cheapjack/MileCastles/README.md

## Milecastles

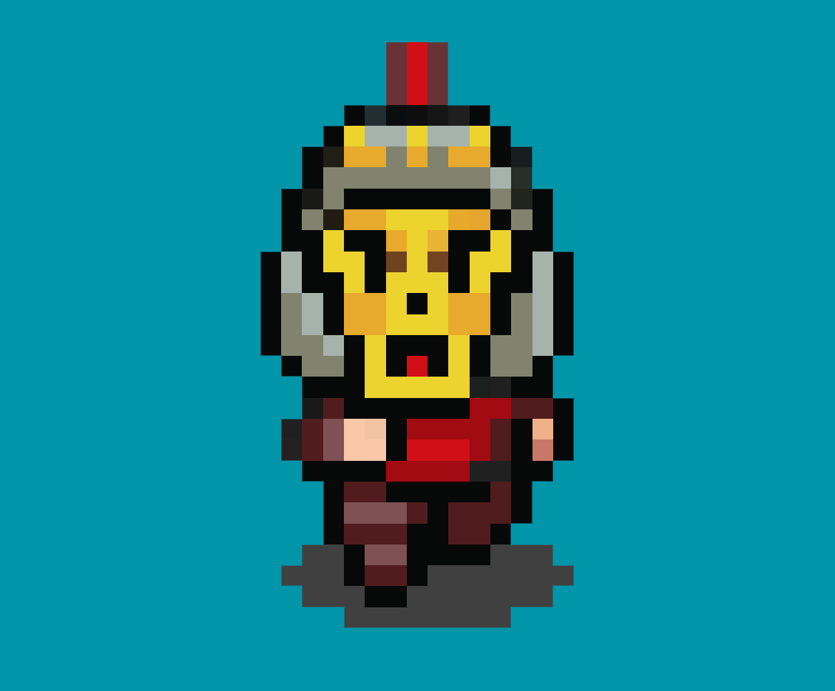
[picture p1: Milecastles-blue-animation.gif]
Soldier Gif


Resources and Issues for development of Milecastles
