cheapjack/MileCastles/boxes/box-colour-refs.pdf

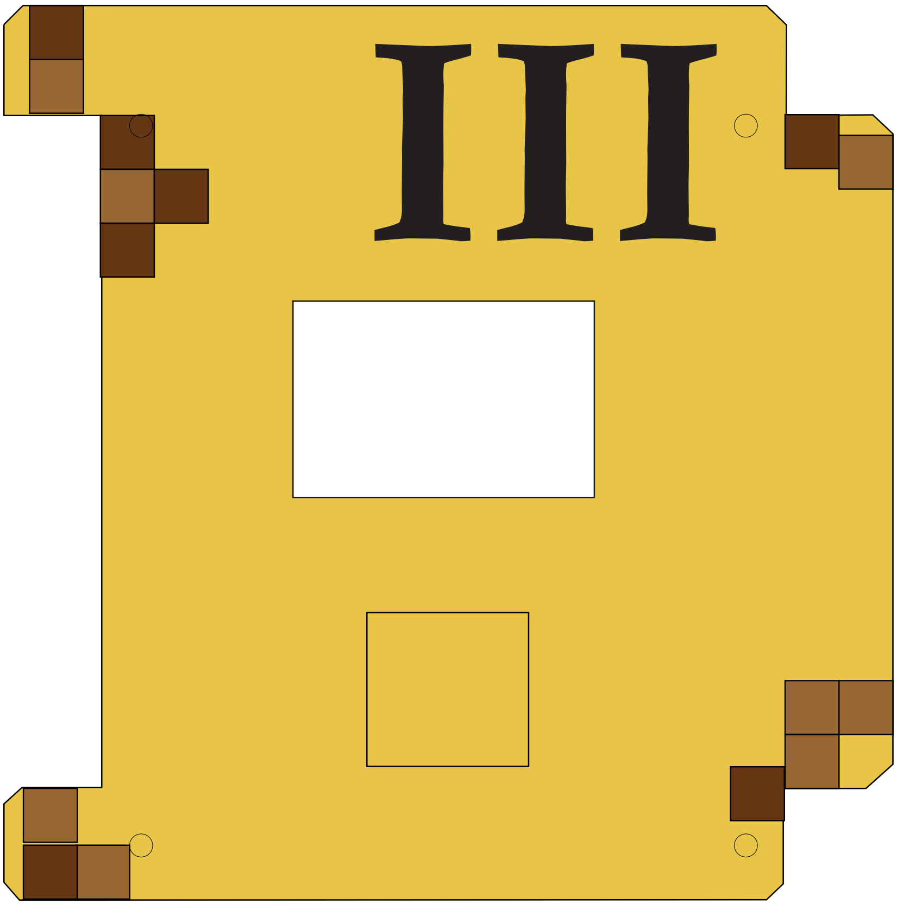
[picture p2: figure]
III
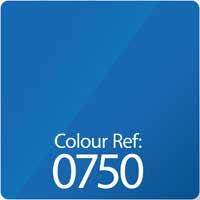
[picture p3: figure]
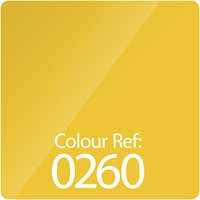
[picture p4: figure]
