cheapjack/MileCastles/screens/1pcs-TM404A-E108467-40x4-4004-40-4-Character-LCD-Module-Yellow-Green-NO-LED-Backlight-KS0066.jpg

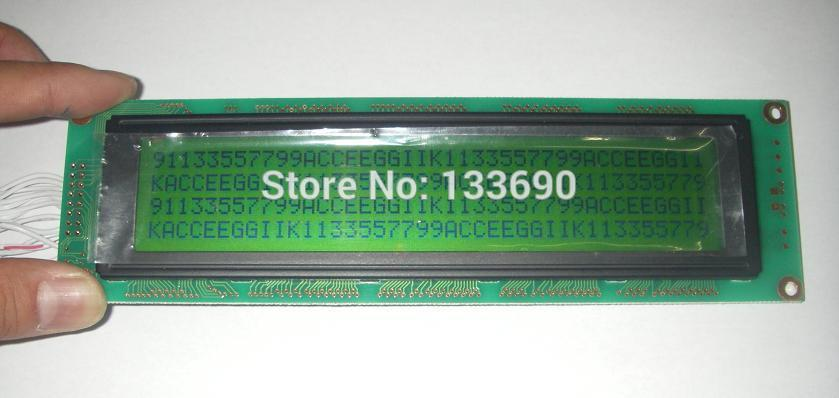
screens/1pcs-TM404A-E108467-40x4-4004-40-4-Character-LCD-Module-Yellow-Green-NO-LED-Backlight-KS0066.jpg
