cheapjack/MileCastles/screens/24-149-thickbox.jpg

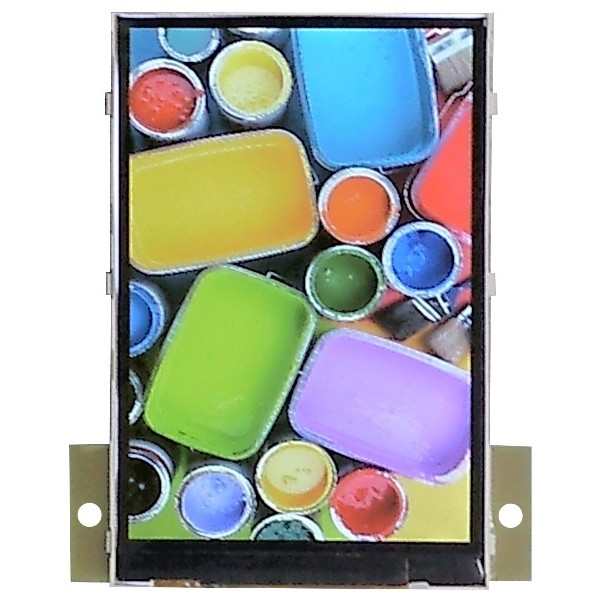
screens/24-149-thickbox.jpg
