cheapjack/MileCastles/screens/24-152-thickbox.jpg

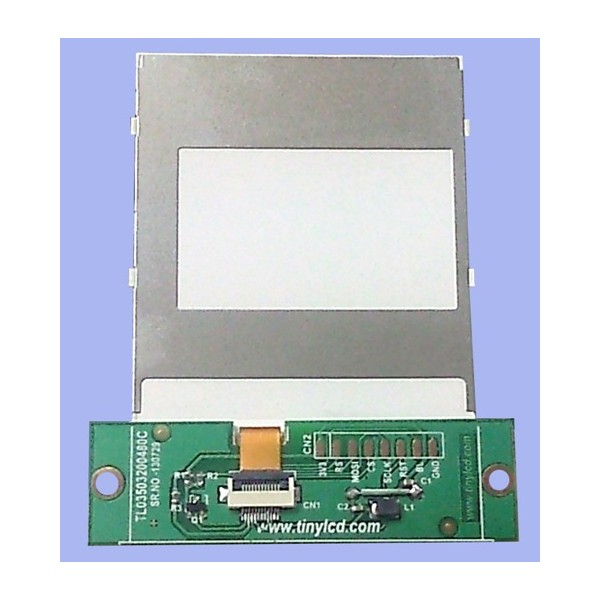
screens/24-152-thickbox.jpg
