cheapjack/MileCastles/screens/61EtGUKPeWL._SL1000_.jpg

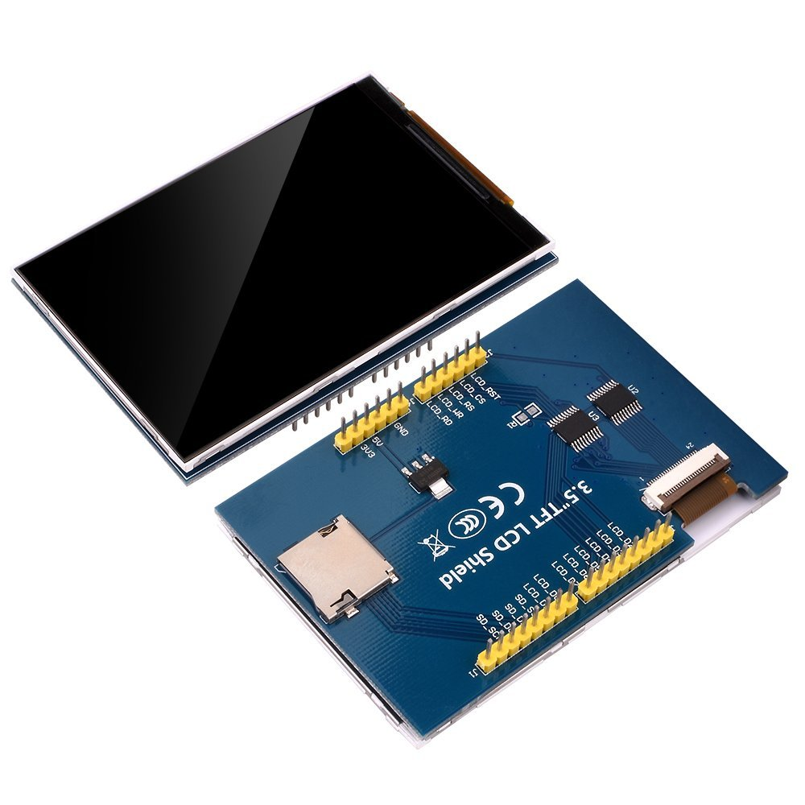
screens/61EtGUKPeWL._SL1000_.jpg
