cheapjack/MileCastles/screens/banggood_arduino_shield.png

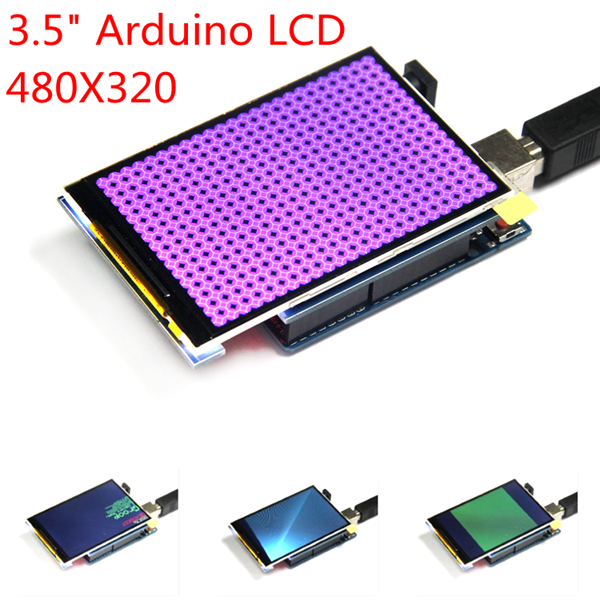
screens/banggood_arduino_shield.png
