cheapjack/MileCastles/screens/buydisplay-spi-3.5in-tft-lcd-320x480-touchscreen.jpg

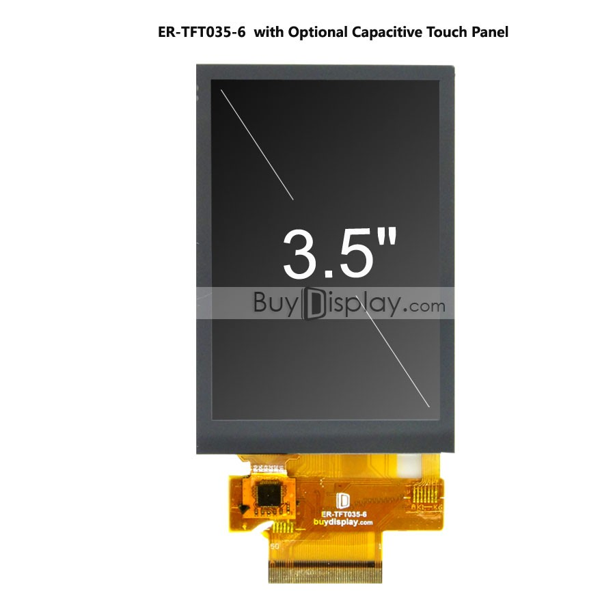
screens/buydisplay-spi-3.5in-tft-lcd-320x480-touchscreen.jpg
