cheapjack/MileCastles/screens/s-l1600.jpg

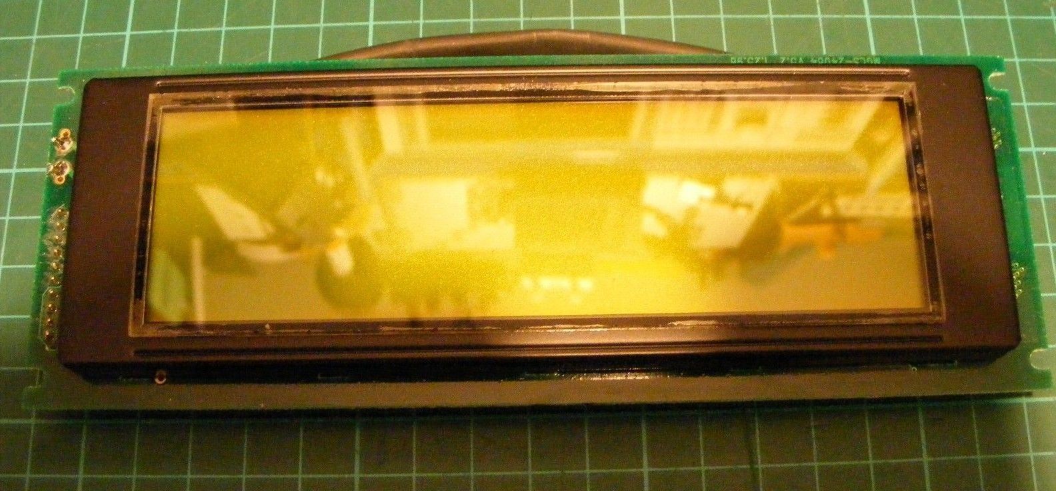
screens/s-l1600.jpg
