cheapjack/MileCastles/screens/TG12864H3-05MB0 - RGB Backlight LCD.jpg

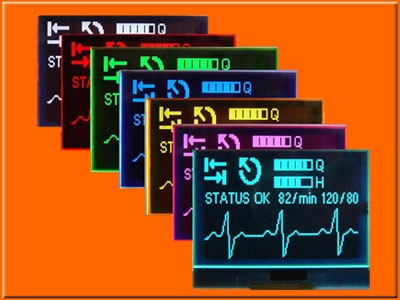
screens/TG12864H3-05MB0 - RGB Backlight LCD.jpg
