cheapjack/MileCastles/componentlist.md

# ComponentList :scroll:

|Item|Got them
|----|----
|RFID tags [with this reader](http://www.electrodragon.com/product/mifare-rc522-rfid-card-readerdetector-ic-card/) **YES**|<ul><li>[x] </li>
|MileCastle round Cavalryman Sticker|<ul><li>[x] </li>

# Boxes Minimum
**17 internals**
**5 externals**
**1 internal with battery**

# Colours for interior
Senhouse 3 white
Tullie 3 white 1 black
Corbridge 3 white
Housesteads 1 white

25 screens in white
25 cockles

## Internals for interior Boxes
|Item|Got them
|----|----
|Headers & dupont connectors|<ul><li>[ ] </li>
|400 point breadboard|<ul><li>[ ] </li>
|Micropython Cockle|<ul><li>[ ] </li>
|90 degree headers for screens|<ul><li>[ ] </li>
|90 degree headers for readers|<ul><li>[ ] </li>
|2 and 4 Dupont Connector Blocks for readers
|1 single male to female for readers
|2 x 4 Dupont Block for Screens|
|2 single male to female for Screens
|2 power jumpers to make a 5V rail for Screens
All 15mm gauge
|[RFID-RC522](http://www.electrodragon.com/product/mifare-rc522-rfid-card-readerdetector-ic-card/) Read/Writers|<ul><li>[x] </li>
|128x64 White Backlit LCD pixel screens|<ul><li>[ ] </li>
|[Panel mount internal micro-USB-B extension](https://www.aliexpress.com/item/1PCS-lot-150CM-OBD-II-OBD2-16-Pin-Male-to-Female-Diagnostic-Extension-Cable/1482186322.html) from micropython cockle port|<ul><li>[x] </li>
|Female USB-A Mains Plug|<ul><li>[x] </li>
|White Male USB-A to Male micro USB-B Extension 3M|<ul><li>[x] </li>
|Female to Male USB-A extenders|<ul><li>[ ] </li>

## Internals for 5 Off-grid Boxes
|Item|Got them
|----|----
|IP66/8 grommet|<ul><li>[x] </li>
|reed switch & magnet|<ul><li>[ ] </li>
|[IP66/68 Rated Waterproof Boxes](https://www.aliexpress.com/item/Low-shipping-cost-high-quality-ip66-plastic-enclosure-box-with-transparent-lid-140-170-95mm/1708264367.html)|<ul><li>[x] </li>
|Headers & dupont connectors|<ul><li>[ ] </li>|<ul><li>[x] </li>
|90 degree headers for screens|<ul><li>[ ] </li>
|90 degree headers for readers|<ul><li>[ ] </li>
|400 point breadboard|<ul><li>[ ] </li>
|Micropython Cockle|<ul><li>[ ] </li>
|[RFID-RC522](http://www.electrodragon.com/product/mifare-rc522-rfid-card-readerdetector-ic-card/) Read/Writers|<ul><li>[x] </li>
|128x64 White Backlit LCD pixel screens|<ul><li>[x] </li>
|Micro B Male to |<ul><li>[x] </li>

## Externals for Off-grid Boxes
|Item|Got them
|----|----
|Internal & External Fixings for side/rear fixing to fence posts/signs|<ul><li>[ ] </li>
|Battery Pack bracket on reverse: additional through hole fixings|<ul><li>[x] </li>
|Box acrylic bent wings for lid socket|<ul><li>[ ] </li>
|Adjust skin for lid|<ul><li>[ ] </li>
|Tinted acrylic Lid with inset magnet|<ul><li>[ ] </li>
|USB Charger port/cable & reed switch lines [grommet plug shell cap cover](https://www.aliexpress.com/item/6-Pieces-Waterproof-Aviation-Connector-Plug-Shell-Cap-Cover-for-GX16/2053433214.html) |<ul><li>[x] </li>
|MicroUSB-B (cockle) extension to exiting USB-A via IP66/8 grommet|<ul><li>[ ] </li>
|Exiting USB-A to an external solar battery pack|<ul><li>[ ] </li>
|[USB Solar battery Pack](http://www.ebay.co.uk/itm/Waterproof-12000mAh-Solar-Battery-Quick-Charger-Power-Bank-Pack-For-Mobile-Phone/262902644680)|<ul><li>[x] </li>

## Externals for on-grid & off-grid boxes
|Item|Got them
|----|----
|Decorative acrylic for Outer Case Designs|<ul><li>[x] </li>
|Internal acrylic material|<ul><li>[x] </li>
|M6 10mm for lid socket|<ul><li>[ ] </li>
|M6 70mm [Coach bolts](http://www.ebay.co.uk/itm/191920495458)|<ul><li>[x] </li>
|M6 100mm [Coach bolts](http://www.ebay.co.uk/itm/191920495458) for off-grid boxes|<ul><li>[x] </li>
|M6 120mm [Coach bolts](http://www.ebay.co.uk/itm/191920495458) for off-grid boxes|<ul><li>[ ] </li>
|M6 nuts|<ul><li>[x] </li>
|M6 nut covers|<ul><li>[x] </li>
|M6 washers|<ul><li>[ ] </li>
