cheapjack/MileCastles/screens/sourcing.md

Links corresponding with screen images 

# Purchased

https://www.adafruit.com/products/250

http://www.buydisplay.com/default/graphic-module-128x64-serial-lcd-display-st7920-black-on-white

http://www.ebay.co.uk/itm/302089090235

https://www.aliexpress.com/item-img/1pcs-40x4-4004-40-4-Character-LCD-Module-Yellow-Green-NO-LED-Backlight-KS0066-controller/32479455308.html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

http://www.banggood.com/3_5-Inch-TFT-Color-Screen-Module-320-X-480-Support-Arduino-UNO-Mega2560-p-1022298.html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

# Not purchased

240x64 lcd pixel display £16.50 but limited avail and problem voltages http://www.ebay.co.uk/itm/Varitronix-MGLS-24064-Graphical-Display-Panel-240-X-64-LED-Backlight-Pinouts-/332077671365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

480x320 TFT with SPI and arduino shield breakouts http://www.tinylcd.com/tiny149/product.php?id_product=61 AND http://www.tinylcd.com/tiny149/product.php?id_product=24 (arrived at via http://www.instructables.com/id/Arduino-and-35-Inch-320x480-TFT-LCD-ILI9488-SPI-In/ )

http://www.vatronix.com/products/75.html (suppliers of Adafruit module)

TFT touchscreen needing ZIF http://www.buydisplay.com/default/serial-spi-3-5-inch-tft-lcd-module-in-320x480-optl-touchscreen-ili9488

FPC (ZIF) connector £4 https://thepihut.com/products/adafruit-50-pin-0-5mm-pitch-fpc-adapter (could be used with LCD screens directly, as per https://www.youtube.com/watch?v=X0mwfAqiqkc and https://github.com/wdim0/esp8266_fast_lcd_driver_hspi )

Another TFT shield £19 https://www.amazon.co.uk/arduino-Kuman-Screen-Socket-Arduino/dp/B01J34JO0K
