cheapjack/MileCastles/boxes/hexnut_tile_cap.stl

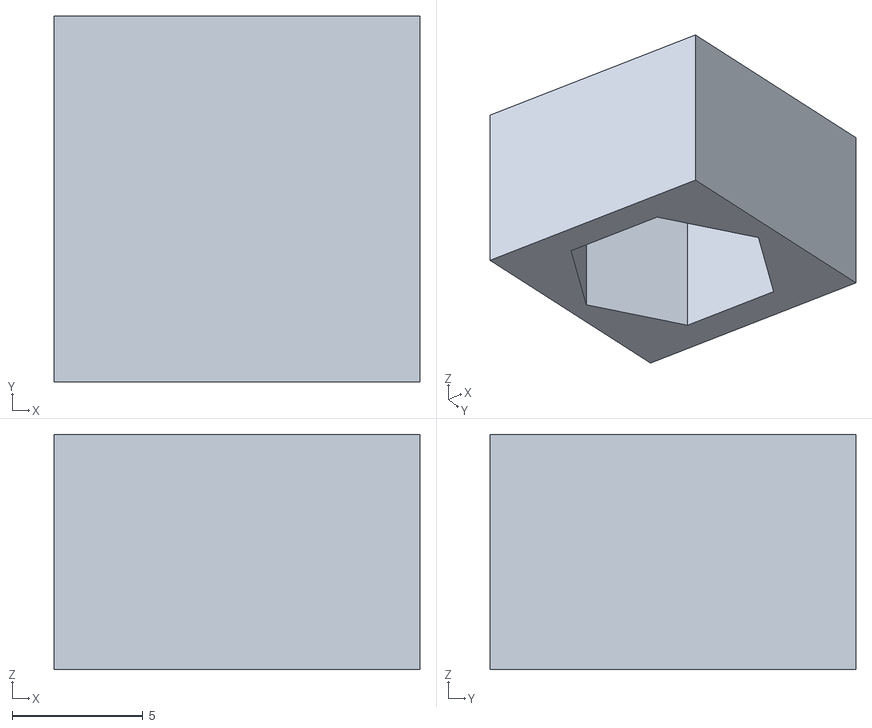
[picture p13: CAD file, 2017-04-25]
boxes/hexnut_tile_cap.stl
14.0 x 14.0 x 9.00
