cheapjack/MileCastles/boxes/AVATOP-INNER-55H-CutsOnSheet.dxf

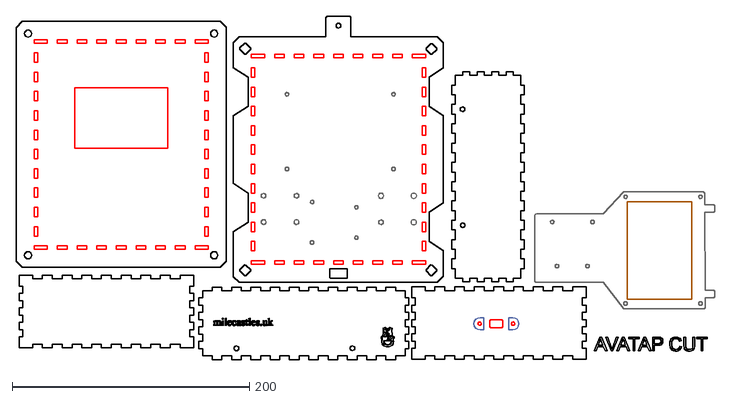
[picture p14: CAD file, 2017-04-17]
boxes/AVATOP-INNER-55H-CutsOnSheet.dxf
589.4 x 289.4
