cheapjack/MileCastles/activity/BoxInstallInfo.md

## Game-Box Install Overview

Live updated [install dates as github issue milestones](https://github.com/cheapjack/MileCastles/milestones)
[Milecastles Site & Logistics Map](https://drive.google.com/open?id=1v-ztNkkMKAI2DC3aoESozsnM2fI&usp=sharing)
[Detailed Info From Site Visits](https://docs.google.com/spreadsheets/d/1O9EbYnrRbLq14Vwc4btC5YH3rWIDOSFfX5Bne3iuhpo/edit?usp=sharing)

## Arbeia (2 indoor, 1 outdoor)
|Venue|Location|Date|Time|Postcode|Phone|Installed|Image No.
|----|----|----|----|----|----|----|----
|Arbeia Roman Fort and Museum|South Shields|tbc|pending|NE33 2BB|0191 277 1410|NO|

|Number of Boxes|Box Type|USB data|Power|Notes
|----|----|----|----|----
|`I,II`|Indoor|OK|OK| 
|`III`|Outdoor|Bad|OK|Will require steel brackets and additional length bolts on top 2 box bolts arranged vertically (supplied). See notes on opening outdoor boxes #114

## Corbridge (3 indoor, 1 outdoor)
|Venue|Location|Date|Time|Postcode|Phone|Installed|Image No.
|----|----|----|----|----|----|----|----
|Corbridge Roman Town|Corbridge|28/6/17|11:30 - 16:30|NE45 5NT|0370 333 1181|YES|YES|1(`corbridge/box*.bin`)

|Number of Boxes|Box Type|USB data|Power|Notes
|----|----|----|----|----
|`I,II,III`|Indoor|OK|OK|
|`IV`|Outdoor|Bad|OK| See notes on opening outdoor boxes #114

## Housesteads (1 indoor, 3 outdoor)
|Venue|Location|Date|Time|Postcode|Phone|Installed|Image No.
|----|----|----|----|----|----|----|----
|Housesteads Roman Fort|Hexham|tbc|tbc|NE47 6NW|01434 344363|NO|NO|

|Number of Boxes|Box Type|USB data|Power|Notes
|----|----|----|----|----
|`I`|Indoor|OK|OK|
|`II`|Outdoor|OK|OK|
|`III,IV`|Outdoor|Bad|OK|See notes on opening outdoor boxes #114

## Segedunum (4 indoor, 1 with battery)
|Venue|Location|Date|Time|Postcode|Phone|Installed|Image No.
|----|----|----|----|----|----|----|----
|Segedunum Roman Fort and Baths|Wallsend|tbc|pending|NE28 6HR|0191 278 4217|NO|NO|

|Number of Boxes|Box Type|USB data|Power|Notes
|----|----|----|----|----
|`I,II,III,IV`|Indoor|OK|OK|`Box IV` needs a battery although its an indoor box. Clear acrylic battery holder with screws supplied 

## Senhouse (3 indoor)
|Venue|Location|Date|Time|Postcode|Phone|Installed|Image No.
|----|----|----|----|----|----|----|----
|Senhouse Roman Museum|Maryport|tbc|tbc|CA15|01900 816168|NO|NO|

|Number of Boxes|Box Type|USB data|Power|Notes
|----|----|----|----|----
|`I,II,III`|Indoor|OK|OK|

## Tullie House (4 indoor)
|Venue|Location|Date|Time|Postcode|Phone|Installed|Image No.
|----|----|----|----|----|----|----|----
|Tullie House Museum and Art Gallery|Carlisle|29/6/17|13:00 - 16:00|CA3 8TP|011228 618718|YES|NO|2(`optimised*.bin`)

|Number of Boxes|Box Type|USB data|Power|Notes
|----|----|----|----|----
|`I,II,III,IV`|Indoor|OK|OK|
