cheapjack/MileCastles/activity/InstallOverview.md

## Game-Box Install Overview

### Installs rolling out inititally Corbridge & Tullie House, then more to follow

Live updated [installs as github issue Milestones](https://github.com/cheapjack/MileCastles/milestones)
[Milecastles Site & Logistics Map](https://drive.google.com/open?id=1v-ztNkkMKAI2DC3aoESozsnM2fI&usp=sharing)
[Info From Site Visits](https://docs.google.com/spreadsheets/d/1O9EbYnrRbLq14Vwc4btC5YH3rWIDOSFfX5Bne3iuhpo/edit?usp=sharing)

|Venue|Location|Date|Time|Postcode|Phone|Installed
|----|----|----|----|----|----|----
|Senhouse Roman Museum|Maryport|tbc|tbc|CA15|01900 816168|NO
Tullie House Museum and Art Gallery|Carlisle|29/6/17|13:00 - 16:00|CA3 8TP|011228 618718|YES
Housesteads Roman Fort|Hexham|tbc|tbc|NE47 6NW|01434 344363|NO
Corbridge Roman Town|Corbridge|28/6/17|11:30 - 16:30|NE45 5NT|0370 333 1181|YES
Segedunum Roman Fort and Baths|Wallsend|tbc|pending|NE28 6HR|0191 278 4217|NO
Arbeia Roman Fort and Museum|South Shields|tbc|pending|NE33 2BB|0191 277 1410|NO
