cheapjack/MileCastles/boxes/WiringRef1.png

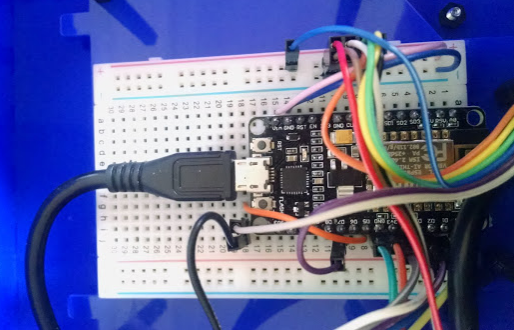
boxes/WiringRef1.png
