cheapjack/MileCastles/boxes/WiringRef2.png

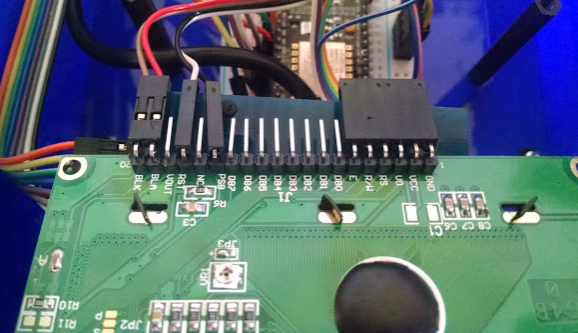
boxes/WiringRef2.png
