cheapjack/MileCastles/print/Milecastles_back.jpg

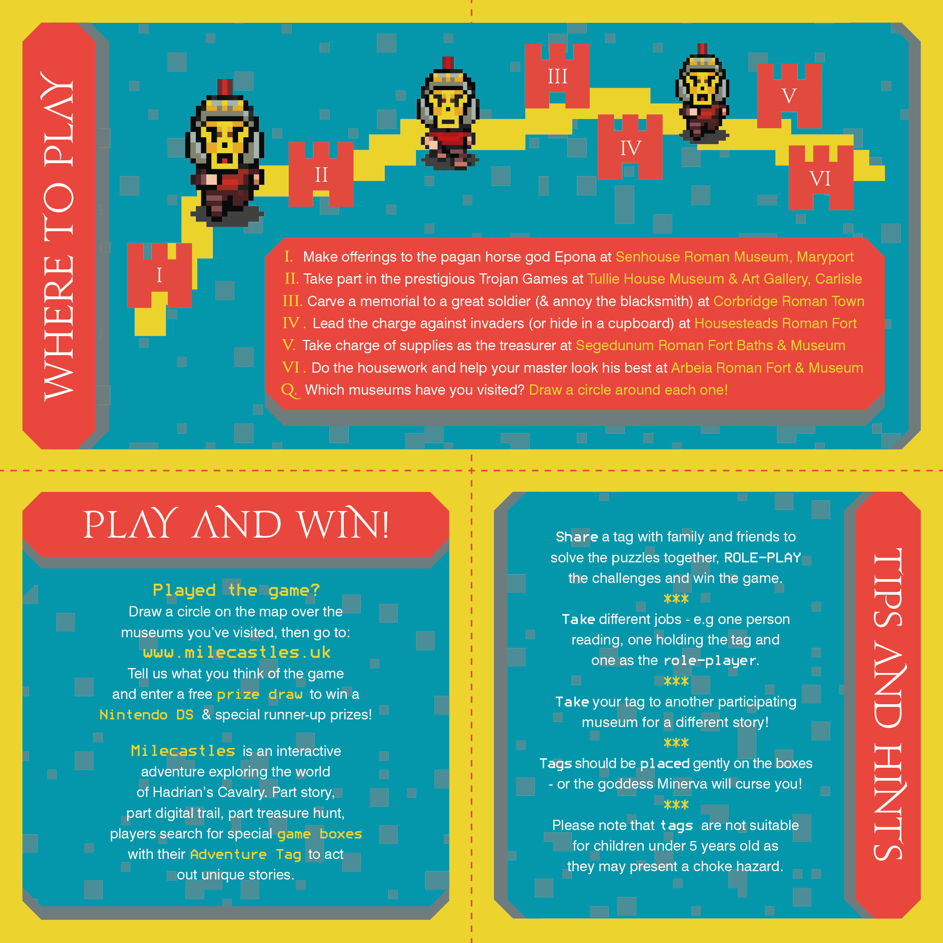
print/Milecastles_back.jpg
