cheapjack/MileCastles/print/Milecastles_front.jpg

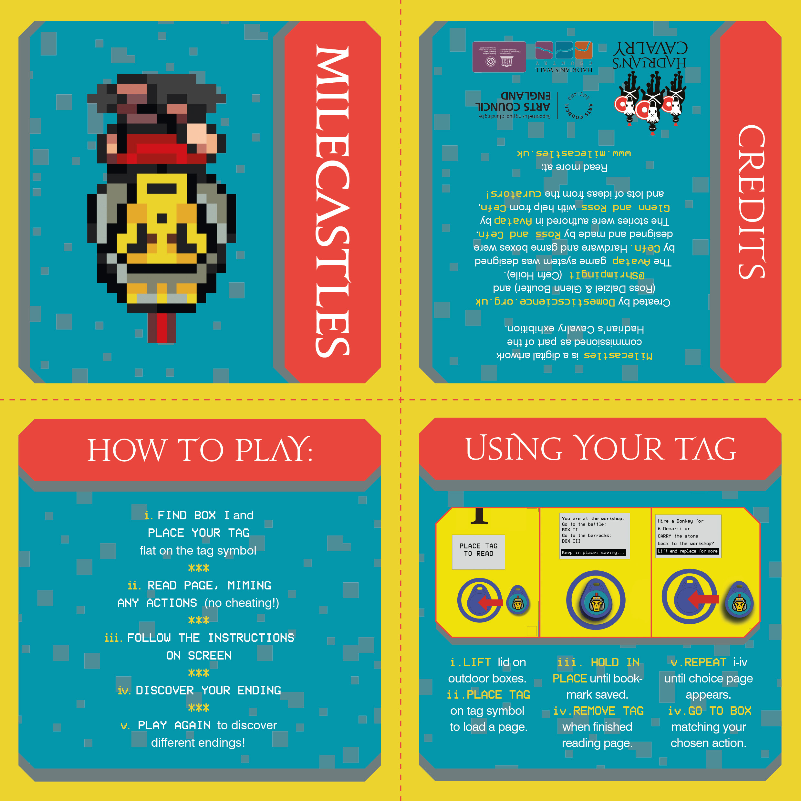
print/Milecastles_front.jpg
