cheapjack/MileCastles/(threads)

Thread 4 (2016-12-19):

Source the RFID cards

cheapjack, 2016-12-19:
Type of card and card reader
Buy some cards & readers to test
Get some advice from @amcewen

amcewen, 2016-12-19:
Readers, I'd generally choose between the [SL030](http://skpang.co.uk/catalog/hf-rfid-module-sl030-33v-i2c-p-1065.html) (and get the [connector cable too](http://skpang.co.uk/catalog/sl030-interface-cable-for-raspberry-pi-p-1222.html) if you're connecting it to a Pi) or the [PN532](https://www.aliexpress.com/item/Free-Shipping-PN532-NFC-RFID-module-V3-NFC-with-Android-phone-extension-of-RFID-provide-Schematic/32271932273.html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,searchweb201602_4_10065_10068_10084_10083_10080_10082_10081_10060_10061_10062_10056_10055_10054_10059_10099_10078_10079_426_10073_10102_10096_10052_10050_425_10051-10051,searchweb201603_2&btsid=e9846656-d245-422b-aaee-121634e06f7c) (haven't sourced many of those yet, but have been looking at them of late)

Tag-wise, the MiFare 1k can be got cheaply (probably knock-off rather than genuine NXP chips) from ebay, or if you look at NTAG213/216 then [ZipNFC](http://zipnfc.com/) is good.  Let me know if you find any better sources.

cheapjack, 2017-03-06:
I based our original ball park figure of 3000 at 40p a unit to give 3000 which did not include printing so we budgeted for

Based on Oomph who do custom printing:

|Number|£ Cost inc. VAT|lead time| Cost per Unit
|----|----|----|----
|1000|648|15 days|0.648
|1500|972|15 days|	0.648

cheapjack, 2017-03-06:
Hey just a headsup for @amcewen Ive just realised a weird arduino bluetooth shield that arrived in the DoES post 2 weeks ago was actually my so called [PN532](https://www.aliexpress.com/item/Free-Shipping-PN532-NFC-RFID-module-V3-NFC-with-Android-phone-extension-of-RFID-provide-Schematic/32271932273.html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,searchweb201602_4_10065_10068_10084_10083_10080_10082_10081_10060_10061_10062_10056_10055_10054_10059_10099_10078_10079_426_10073_10102_10096_10052_10050_425_10051-10051,searchweb201603_2&btsid=e9846656-d245-422b-aaee-121634e06f7c) order from AliExpress so this doesn't inspire confidence!

cheapjack, 2017-04-05:
@cefn Pretty sure we are using [these now](http://www.electrodragon.com/product/mifare-rc522-rfid-card-readerdetector-ic-card/) so I think we are best going with the cheaper RFID tags with MileCastles stickers of our little roman character @gkboulter made. So lets just go with that and get 1000 to start with

cheapjack, 2017-04-06:
Closing as we've chosen cheaper tags (with stickers) that will work [with this reader](http://www.electrodragon.com/product/mifare-rc522-rfid-card-readerdetector-ic-card/)

Closed 2017-04-06.

Thread 7 (2017-01-02):

Will we need to cook any boards?

cheapjack, 2017-01-02:
Breadboarding may not give us the physical robust-ness required for the game boxes, so some boards design for connecting screens/LEDs/NFC/RFID modules to cockle pins & headers may need to be considered depending on cost.

cheapjack, 2017-03-09:
think yes to improve robustness, increase speed and accuracy of assembly need to think on lead-time, closing to move to #26

Closed 2017-03-09.

Thread 11 (2017-01-22):

Make prototype stories for venues that want to get involved with content

cheapjack, 2017-01-22:
After surveying sites we need to write simple stories based on initial conversations, some people more involved than others.

Site | People | Subject | Done | Staff Helping Make Content?
----- | ----- | ----- | ----- | -----
Arbeia | Alex | Commanders Stables/Victor the groom | <ul><li>[ ] </li> | <ul><li>[ ] </li>
Segedunum | Trevor | Life in the cavalry / Horse sfx | <ul><li>[ ] </li> | <ul><li>[ ] </li>
Great North Museum | Joanne | Needs Follow up email | <ul><li>[ ] </li> | <ul><li>[ ] </li>
Corbridge | Frances & Kevin | Horse paraphenalia / Artist Apprenticeship | <ul><li>[x] </li>
Housesteads | Frances & Kevin | Not sure / Vast 5 acre site | <ul><li>[ ] </li> | <ul><li>[x] </li>
Chesters Roman Fort | Frances & Kevin | *Not using this site* | <ul><li>[x] </li> | <ul><li>[ ] </li>
Roman Vindolanda | Barbara Birley | Agriculture / Retirement / Shepherds | <ul><li>[x] </li> | <ul><li>[ ] </li>
Roman Army Museum | Barbara Birley | Military? | <ul><li>[ ] </li> | <ul><li>[x] </li>
Tullie House | Tim & team | Trojan Games / Complex |  <ul><li>[x] </li>
Senhouse Maryport | Jane Laskey | Epona / Libations, Religion & the Coastal Frontier | <ul><li>[ ] </li> | <ul><li>[x] </li>

cheapjack, 2017-01-22:
Prototype the stories in Twine

gkboulter, 2017-01-23:
Created a quick summary of site visits and notes on story themes/ideas:
[google drive link](https://docs.google.com/spreadsheets/d/1O9EbYnrRbLq14Vwc4btC5YH3rWIDOSFfX5Bne3iuhpo/edit?usp=sharing)

cheapjack, 2017-01-27:
We've got some material in gdrive now
[A Simple Story Spreadsheet](https://docs.google.com/spreadsheets/d/1wpaTXbh_3mRi3xCvBE2t_YKRgHbxEAwHyVIlOl4Fk4k/edit?usp=sharing) to get people going
A more comprehensive [Prototype Story Sheet](http://bit.ly/MileCastlesStory) and a [Site Information sheet](http://bit.ly/MileCastleSiteInfo)

gkboulter, 2017-02-27:
Have made a very basic Twine game for Corbridge based on Frances' story.
[Twine file and html file are here:]
(https://drive.google.com/drive/folders/0B18v6qTGYbxYRFM0WFNhNWlJWEk)
Has two different endings at the minute based on if you sharpen your tools.
I got the currency variable working but need to build in some fail states when you drop below zero / run out of money.
It's laid out to be read left to right and passages are numbered per box (eg 1.2 = box 1, text 2).
Can work on it some more once I know if it looks possible in JSON or other format.

Closed 2017-03-06.

Thread 18 (2017-02-08):

What are our core transactions in the game?

cheapjack, 2017-02-08:
### Transactions

Acts which are parts of players’ behaviour intended to be detected, or coordinated through tapping into specific points in the RFID+Screens platform. Let’s assume that anything is possible for now, and we’ll limit the set of available transactions depending on hardware limitations when we have them.

- die/fail - Biggest shortcoming of first prototype stories that there were no game overs. Starting/respawning  again is a mechanic not to be afraid of
- carry - go from one place where something can begin to travel with you, to another place where you part ways with it [effectively a single-item inventory]
  - Examples: Get libation, get grain, get sword bring the cavalry, deliver a message - Prompt to visit specific box / Visit a location the box represents , choose an item 2-3 multiple choice return it to another box
 - meet - a character is introduced to you [you may learn something, begin or complete a transaction, start playing as that new character, (e.g. carry something to…, bring a message from...)
  - Examples: The party organisers need an amphora, should you visit the quartermaster (go to station A) or the garrison commander (go to station B). If you don’t know what is an amphora, (go to station C to find out/the amphora display)
- retrieve - a finding task which may combine with a carry , meet  or race

- investigate - a puzzle is presented, with a choice which stimulates moving through the museum and learning, cunning hidden information can only be disclosed by doing an activity (e.g. visible on inside of helmet when worn, on top of horse when ridden - see Overlay section)
- solve - a puzzle is presented, demanding a choice which stimulates thinking
  -    Examples:  Fact written somewhere in text panel that we describe location of *noted this could be helped by sticker wayfinding or compass - budget depending*
  - Visit a location choose an answer to question 2-3 multiple choice affects another box or prompts new location. Question relates to nearby museum panels.
Start a quest to answer 2 questions from museum context or a sign outside the building

- buy - an amount of money you have is spent in exchange for inventory items

- race - a carry, solve or investigate against a countdown clock

- fight - some kind of attack choice
- escape - decide which other station you will run to, to find safe harbour. Maybe stay and tap this box to fight, go to Box B to escape!

- watch - pause and look, e.g. count to ten in roman, learn the spelling and meaning of a roman word for which you will be challenged later..

Multiplayer

- hide - e.g. encourage player 1 to go and hide somewhere (e.g. give a secret instruction to them where to hide, then show a countdown in roman numerals, finally give a clue to player 2 where player 1 is hidden) Bringing the card back proves the seeking player has found the hiding player
co-task - any task which combines the contribution of two separately identified cards carried by members of a co-playing group (could be an easter egg, or additional levels which can be unlocked for multi-player, including cooperative or competitive features)

- Prompt to visit specific box with time limit thats far away RUN!!
- If 3 or more players within 5 mins get team points?

### Motifs

- Idea of spawning into specific characters in the most relevant timelines... not sure if generic character types would work as each venue seems to suggest a certain type; An ambitious cavalry member at the Hippika Gymnasia Games at Tullie House, An artisan apprentice at Corberia, A farmer/retired commander at Vindolanda, a groom at Arbeia, A warrior/cleric/gods rep at Senhouse
- Mars - Epona - Minerva multi choice altar boxes at Senhouse

### Overlay/Wayfinding
This is a word to describe the additional features provided in the space, or as part of registration to help people navigate. Many of these could be printed material

Signpost stickers to named stations -  *possibly* but not sure they will go with that: we've sold idea that the text is the guide and that it's otherwise non invasive; to switch now to additional overlays is hard to argue
Footsteps glued to floor - to invasive
handheld maps - print
game guide leaflets (graphical depictions surfacing different transactions) - print
character guide leaflets - print (all on one)

cheapjack, 2017-02-13:
We need some really nice diverse gameplay that makes people feel but also we need to fix our main transactions on Friday i thing or we will just have too many options to work with/present to Tim & Frances next week ! - #boringcop

Closed 2017-03-28.

Thread 19 (2017-03-02):

Design principles - No choices at the same box

cefn, 2017-03-02:
Navigating through the example Twine, (which is excellent thanks, @gkboulter ) it's made me think also of some things which could be improved by following a handful of design principles, which I'll raise as single issues.

What does anyone think of the following...

* Choices should never include the same box
    * Pros
        + This avoids the possible failure of mistakenly tapping twice and skipping to the next game
        + It allows us the option to always provides 'view pages again' at the same box, especially when there are multiple pages which a group might need to re-read/consider
        + It avoids the potential distortion of story expansion from people always clicking on the box which is right in front of them for convenience
    - Cons
       + It means stories have to be designed with a close coupling between 'legs' between boxes, and the relevant content next to a box
        + It limits the number of choices at each junction point to 3 (assuming we have 4 boxes per venue)

gkboulter, 2017-03-02:
Some notes and feedback from phone conversation with @cefn earlier today:

More on design principles:
- Refer to boxes as places rather than numbers.
Eg at Corbridge, Box 2 is the Stonemason's Workshop / Box 4 is the Merchant's Shop
- Set an ideal number of passages (e.g. Corbridge is around 55 at the minute)
- Set an average number of characters per passage in relation to how much can fit on to chosen screen size at once

Things to check for:
- Passages that link to non-existent passages
- Passages that link to passages outside of the current individual story / museum (if this becomes an issue).
- Flag up incorrect ID formatting for passages?
- Flag up incorrect formatting when using variables / conditions?

Passage types:
- Page
- Choice (3 options, current box should not be an option)
- Conditional - routes to more than one passage based on a value or condition
- Wait (not implemented in prototype). Used to give people time to carry out physical task, examine cabinets etc.).

Things we might use the Sack for:
- Currency / denarii
- God points / Roman karma
- TIme of day / time limited actions
- Specific objects collected
- To note game outcomes - e.g. Fail / Pass / Success (provide a score across all games?)

Possible useful elements for visual rendering:
- It would be useful to see the passages represented either as a Grid or as a List (see screenshot from Inform 'World Index').
- Some way of showing the passages in correct order of play
- A representation of links between passages
- Colours / labels to clearly differentiate between which box each passage belongs to.
- Labels to identify type of passage (page / choice / conditional etc)
- List of 'sack' variables

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

cheapjack, 2017-03-02:
Sorry missed call and feedback on all this today. In middle of something then got pulled into a tonne of family stuff and other work. All really good stuff. Will digest and respond tomorrow properly.

Despite cons of *"Choices should never include the same box"* wonder if this is a good idea. Promotes movement around space despite losing some choice or being able to choose to wait...

More tomorrow thanks both!!

cheapjack, 2017-03-06:
Sorry my very late comments on this

| More on design principles:|Comment
|----|----
| Refer to boxes as places rather than numbers. Eg at Corbridge, Box 2 is the Stonemason's Workshop / Box 4 is the Merchant's Shop | Yes but still like the idea of a roman numeral on the box
| Set an ideal number of passages (e.g. Corbridge is around 55 at the minute) | good idea maybe aim for 60 initially
| Set an average number of characters per passage in relation to how much can fit on to chosen screen size at once | Yes what do you think?

| Things to check/Validate for:
|----
| Passages that link to non-existent passages
| Passages that link to passages outside of the current individual story / museum (if this becomes an issue).
| Flag up incorrect ID formatting for passages?
| Flag up incorrect formatting when using variables / conditions?
**Added:**
|----
| print the value of a variable `true` `0-255`
| Verify a `passage visited` variable? Alot of prototype used that

|Passage types:| Comment
|-----|----
| Page
| Choice (3 options, current box should not be an option) | I can see that it could cause confusion so agree with @cefn on the "No choices at the same box" and that someone could casually choose the current box whereas if you always have to go somewhere else it avoids this & promote exploration.
**Added:**
| Conditional - routes to more than one passage based on a value or condition glenn used <<visited("PassageNumber")>>
| Wait (not implemented in prototype). Used to give people time to carry out physical task, examine cabinets etc.).| You dont really need to wait; you can always say "wait by the blacksmiths" or "go wait in the workshop"

|Things we might use the Sack for:
|----
| Currency / denarii
| God points / Roman karma
| TIme of day / time limited actions
| Specific objects collected
| To note favourable game outcomes - e.g. Fail / Pass / Success (provide a score across all games?)
**Added:**
| a $visitedpassage variable as above wonder if this is a sack item then rather than a type of passage

Closed 2017-03-17.

Thread 21 (2017-03-06):

Make a video of card activating a screen

cheapjack, 2017-03-06:
@cefn do you think you'd be able to make a short video/gif of a card activating the black on white screen you showed us in the Tullie House cafe? Would you mind doing that for Wednesday.Then we can send to Lisa / management team

cefn, 2017-03-06:
I will do what I can, but had until now prioritised the story modelling with the aim of ensuring you have a framework for authoring.

For this reason, although Wednesday is a reasonable target and I will begin working on it, I cannot be sure I won't hit short-lived technical issues wiring both together through the cockle.

I feel it would be a bad idea to invest engineering time in a parallel technology (e.g. using Arduino) for no reason, unless it's super-quick to do, and it wouldn't mean much anyway.

cheapjack, 2017-03-06:
Agree, focus on the story framework but see if theres a quick screenshot of the 40x4 screen possible great but only if that makes sense. Dont want to divert!

We are going to send a cleaned up version of the Corbridge story to them as a deliverable. Dont want to make something for showing thats not useful down the line to the project. If we can get an authoring framework for Thursday or Friday that will really help get that going I think thats still a priority, then hardware end of the week/next
thanks!!

Closed 2017-03-17.

Thread 24 (2017-03-06):

"Arrival" text inconsistent with interaction model - suggests feature - fallback behaviour

cefn, 2017-03-06:
The reference Twine story includes the following text. "Welcome to Milecastles at Corbridge!\nGet your registration card from the till and tap the symbol below to begin!"

Although this makes sense in Twine which has a context for knowing where you are in the story before you click anything, I can't quite make sense of how it should be presented through our interaction model.

The start box is just the first box you encounter, and it doesn't know you are coming to the game new as you walk up to it, or indeed that anyone is approaching at all (you might be approaching the box as stage 7 in a partially completed game, and it has had no interaction with you yet as you haven't tapped).

I think the implication or suggestion might be that the box should show something when it is not being interacted with, but this remains true through all boxes at all times, when there has been no recent interaction, and should be designed separately.

Would be good to get a specification from @cheapjack  and @gkboulter as to what this fallback behaviour should be.

cheapjack, 2017-03-06:
Maybe this should really be in the print theres not a real reason for it to be on the 'first' box I think just hangover from early thinking. If they are seeing the message they already have a card!

cefn, 2017-03-06:
Although the screens are free advertising.

cheapjack, 2017-03-06:
True! Just dont want to add anything we dont really need... can you chat on phone for a moment?

cheapjack, 2017-03-06:
I'll work on this agree we need something after conversation earlier

cheapjack, 2017-03-28:
Think this is getting covered in #30 and #37 now so closing for now

Closed 2017-03-28.

Thread 25 (2017-03-06):

Get Quote for Additional Print to include in Project report

cheapjack, 2017-03-06:

cheapjack, 2017-03-06:
I think @gkboulter said about £900 for 1000 folded double sided print on a nice paper stock board will need this to be accurate to approve I think

gkboulter, 2017-03-06:
**Option 2:**
_Printed Oyster card wallets w/ instruction card insert_

Oyster Card holders / full colour on outer / 2 inner pockets
1000 @ £0.42 = £420 / £504 inc. VAT
1500 @ £0.42 = £630 / £756 inc. VAT
Quote from Fluid Branding:
[Quote site link](http://www.fluidbranding.com/oyster-card-ticket-wallet-1287808377.html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)

_Business card inserts w/ instructions_
Standard size / colour both sides / recycled board / rounded corners
1000 cards @  = £64.49 /  inc. VAT £77.39
2000 cards @ £0.05 = £ 108.54 / inc. VAT £130.25
[Quote from printed.com
](https://www.printed.com/products/8/business-cards)

**Total cost:**
1000 wallets and cards - £504 + £77.39 + £20 delivery = **£601.39**
1500 wallets and 2000 cards - £756 + £130.25 + £20 delivery = **£906.25**

gkboulter, 2017-03-06:
**Option 1**
_Printed A5 sheet folded into quarters to hold card_

_A5 Sheets / colour both sides / on 250gsm / recycled paper_
1000 sheets - £262.45 / inc. VAT £314.94
1500 sheets - £379.95  / inc. VAT £455.94
[Quote from Printed.com
](https://www.printed.com/products/3/folded-leaflets)

_Glue Dots to mount cards (5000 peelable)_
£31 + £8 delivery  = £39
[Quote from Tapes Direct
](https://www.tapes-direct.co.uk/index.php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)

**Total cost:**
1000 sheets / 5000 glue dots - £314.94 + £31 + £20 delivery = **£365.94**
1500 sheets / 5000 glue dots - £455.94 + £31 + £20 delivery = **£506.94**

**Needs assembling!**
The printer quoted will only do one fold so would need a day to add a second fold to all the sheets...
Can we add one or two days assembly at £100 / £150 per day?
E.g
1000 sheets / 5000 glue dots - £314.94 + £31 + £20 + £300 assembly = **£665.94**
1500 sheets / 5000 glue dots - £455.94 + £31 + £20 + £300 assembly = **£806.94**

gkboulter, 2017-03-06:
Self folding (aiming at £1 per card) to sell for £2

Cards are 65p / print should 35p

gkboulter, 2017-03-06:
**Compasses:**

Alternatively these (successfully copying in Glenn this time) - they could be glued to the RFID cards, making for quite a different kind of experience, solving the need for mapping/stickers perhaps (instructions like walk north west to station Q) as well as suggesting navigation between the Milecastles.

[quote
](https://www.aliexpress.com/item/100pcs-Pack-Clear-Liquid-filled-Button-Small-Mini-Survival-Compass-for-Outdoor-Sports-Camping-Hiking-FLQ177/32594601295.html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,searchweb201602_1_10065_10068_10000074_10000032_119_10000025_10000029_10000028_10060_10000067_10062_10056_10055_10000062_10054_10059_10099_10000022_10000013_10103_10102_10000016_10096_10000019_10000056_10000059_10052_10053_10107_10050_10106_10051_10000053_10000007_10000050_10084_10083_10000047_10080_10082_10081_10110_10111_10112_10113_10114_10115_10000041_10000044_10078_10079_10000038_10073_10000035_10122_10121,searchweb201603_10,afswitch_2,single_sort_1_price_asc&btsid=0c367945-0796-4a65-8749-3cbf95a8f10e)

gkboulter, 2017-03-06:
**Option 4**
_A6 Postcards - could add glue dots for staff to assemble(?)_

_A6 / colour both sides / 350gsm matt_
1000 x **0.11** = £ 107.10 / inc VAT £128.52 + £12 delivery / **Total £140.52**
1500 x **0.10** = £154.22 / inc VAT £185.06 + £12 delivery / **Total £197.06**
[Quote from printed.com](https://www.printed.com/products/5/postcards)

Optional: Peelable glue dots @ £30 for 5,000 (see above for link)

cheapjack, 2017-03-06:
Overview of extra print and RFID cost (providing the NXP Mifare 1K is right)

| Name |Number|£ Cost inc. VAT|lead time| Cost per Unit
|----|----|----|----|----
|RFID Card Printed|1000|648|15 days|0.648
|RFID Card Printed|1500|972|15 days|	0.648
|Size 210 x 210 2xside print|1000|289.26|inc delivery|0.29
|Size 210 x 210 2xside print|1000|433.89|inc delivery|0.29

cheapjack, 2017-03-07:
Overview of extra print and RFID cost (providing the NXP Mifare 1K is right)

| Name |Number|£ Cost inc. VAT|lead time| Cost per Unit
|----|----|----|----|----
|RFID Card Printed|1000|648|15 days|0.648
|RFID Card Printed|1500|972|15 days|	0.648
|Size 210 x 210 2xside print|1000|289.26|inc delivery|0.29
|Size 210 x 210 2xside print|1000|433.89|inc delivery|0.29

So basically subsequent card and print would be £0.94 a unit but ive not included compasses in this

Closed 2017-03-17.

Thread 26 (2017-03-09):

Designs for a circuit board footprint to hold the NodeMCU Amica R2, RFID & screen inputs

cheapjack, 2017-03-09:

cheapjack, 2017-03-09:
Got [KiCad parts library](https://github.com/skorokithakis/kicad-lib) with the NodeMCU Amica R2

cheapjack, 2017-03-09:
Any initial pin mappings welcome will put KiCad files up once I know what im doing

cheapjack, 2017-03-09:
Outdoor weatherproofing, the NodeMCU & connector board could live in one of [these](http://www.ebay.co.uk/itm/Waterproof-Junction-Box-Underground-Cable-Line-Protection-Sleeve-Connectors-IP66-/291691261143) then with another sealed and glued outer acrylic skin. Prototyping one next week.

cheapjack, 2017-04-04:
Switching to breadboards mounted on the interior slab

Closed 2017-04-04.

Thread 29 (2017-03-17):

Establish character size and limit

cheapjack, 2017-03-17:
Hi heres some svgs using this [font](https://fontstruct.com/fontstructions/show/840449/5x7_monospace_ce)

[ThroughPage](https://github.com/cheapjack/MileCastles/blob/master/svg/ThroughPage_workIntro.svg)
[NodeFork](https://github.com/cheapjack/MileCastles/blob/master/svg/NodeFork.svg)

So really we need some kind of 5x7 monospace font but only using 4x6 as black and I just can’t find a ttf font for that to mock up
[this one](https://fontstruct.com/fontstructions/show/12001/basic_5x7) is more like it but capitals use the full 5x7 pixels

Basic limits:
### ThroughPage
 * 26 characters across 8 lines with an additional TAP TO CONTINUE… message at the bottom, right justified.

Like idea of have any choice or interaction inverted (white on black) to keep all simple: box around choices does not seem to look as good.. do you think it could flash (alternate) or is that a pain?

### NodeFork
Choices are seperate into NodeForks:
 * 24 characters on line 1
 * 13 characters on line 2 allowing for “ at Box III” at the end and 3 space indents

It will mean limiting what can appear on each screen render and choices but i think we can cope with this all files for mockups attached. I edited in a text editor and then made in illustrator. A screen grab would have been quicker! But this is a genuine 128x64 pixel images just with not an ideal font. If we can use the font from the arduino example you had cefn I think thats ideal.

cheapjack, 2017-03-17:
These are latest mockups for the rules above

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

cheapjack, 2017-04-20:
## NodeFork behaviour

`Choose from the following` is the default in milecastles.py and can be overidden with a `page=` in a NodeFork JSON

Then your choice text is 1.5 full lines for 3 choices for example or 2 full lines but need to render a few things to try.

Closed 2017-05-18.

Thread 31 (2017-03-21):

Confirm component list

cheapjack, 2017-03-21:
## Externals for on-grid & off-grid boxes

- [ ] Clear inset acrylic to protect screen.
- [ ] Decorative acrylic for Outer Case Designs
- [ ] Internal acrylic material
- [ ] M6 60mm [Coach bolts](http://www.toolstation.com/shop/p98056?table=no)
 - [ ] M6 nuts
 - [ ] M6 locking top nuts
 - [ ] M6 washers

## Internals for On-grid Boxes

- [ ] Breakout Board? (time sensitive: move into an enhancement issue for later date)
 - [x] Switched to headers & connectors & breadboard: *possibly less robust*
- [x] Panel mount micro-usb extension from micropython port
- [x] Tap only interaction

## Externals for Off-grid Boxes
- [ ] Battery Pack bracket on reverse: additional through hole fixings
- [ ] Box acrylic bent wings for lid socket
Adjust skin ou
- [ ] Tinted acrylic Lid with inset magnet
- [ ] Micro-usb extension from Micropython board to panel mounted micro usb on external box
 - [ ] Maybe miss this out and go straight to battery
- [ ] 3M Microusb-usb2 extension from panel mounted  to an external solar battery pack
- [ ] External Battery
- [ ] USB Charger port/cable & reed switch lines grommet: [plug shell cap cover](https://www.aliexpress.com/item/6-Pieces-Waterproof-Aviation-Connector-Plug-Shell-Cap-Cover-for-GX16/2053433214.html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,searchweb201602_1_10065_10130_10068_433_434_10136_10137_10138_10060_10062_10141_10056_10055_10054_10059_10531_10099_10530_10103_10102_10096_10052_10144_10053_10050_10107_10142_10051_10106_10143_10526_10529_10084_10083_10080_10082_10081_10110_10111_10112_10113_10114_130_10078_10079_10073_10070_10122_10123_10124-10531,searchweb201603_13,afswitch_1,ppcSwitch_5,single_sort_0_default&btsid=de604ddb-1c8f-4118-8fd9-1da51a4d2243&algo_expid=5854297a-285c-43ec-b16f-733276a5f273-6&algo_pvid=5854297a-285c-43ec-b16f-733276a5f273) over a lasercut external o-ring to fit

## Internals for 6 Off-grid Boxes

- [ ] reed switch & magnet
- [ ] IP66/68 Rated Waterproof Boxes
- [ ] 1 x IP66 grommet
- [ ] Breakout Board? (time sensitive)
 - [x] Switched to headers & connectors & breadboard: *possibly less robust*
400 point breadboard

- [x] Micropython Board
- [ ] USB battery Pack
 - with one output and input? like on [this](http://www.ebay.co.uk/itm/50000mAh-External-Power-Bank-Backup-USB-Battery-Charger-For-Phones-iPad-MP4-2017-/142297207624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)

cheapjack, 2017-03-24:
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

MIcro-usb like [this](https://www.aliexpress.com/item/Freeshipping-USB-Micro-B-Panel-Mount-Female-to-USB-Micro-B-male-Extension-Cable-M-F/32707770336.html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,searchweb201602_1_10065_10130_10068_433_434_10136_10137_10138_10060_10062_10141_10056_10055_10054_301_10059_10531_10099_10530_10103_10102_10096_10052_10144_10053_10050_10107_10142_10051_10106_10143_10526_10529_10084_10083_10080_10082_10081_10110_10111_10112_10113_10114_130_10078_10079_10073_10070_10122_10123_10124,searchweb201603_13,afswitch_1,ppcSwitch_5,single_sort_0_default&btsid=c017719c-ad35-4f46-b183-7c97d1204e56&algo_expid=109af307-e5ce-409a-a726-3451396e928e-0&algo_pvid=109af307-e5ce-409a-a726-3451396e928e) may be best for a charging point at base of the unit with a laser cut rubber grommet & plug to protect from water.

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

Possibly combine with an aviation connector [plug shell cap cover](https://www.aliexpress.com/item/6-Pieces-Waterproof-Aviation-Connector-Plug-Shell-Cap-Cover-for-GX16/2053433214.html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,searchweb201602_1_10065_10130_10068_433_434_10136_10137_10138_10060_10062_10141_10056_10055_10054_10059_10531_10099_10530_10103_10102_10096_10052_10144_10053_10050_10107_10142_10051_10106_10143_10526_10529_10084_10083_10080_10082_10081_10110_10111_10112_10113_10114_130_10078_10079_10073_10070_10122_10123_10124-10531,searchweb201603_13,afswitch_1,ppcSwitch_5,single_sort_0_default&btsid=de604ddb-1c8f-4118-8fd9-1da51a4d2243&algo_expid=5854297a-285c-43ec-b16f-733276a5f273-6&algo_pvid=5854297a-285c-43ec-b16f-733276a5f273) over a lasercut external o-ring to fit

cheapjack, 2017-03-24:
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

 - Made a cockle without breadboard in an [IP66 rated box](http://www.ebay.co.uk/itm/-/291923363585?roken=cUgayN) and just plugin ribbon cable works but is fiddly and would still need a power rail but **do-able**.

USB power pack would be external to this box;  maybe an issue 😕

cheapjack, 2017-03-28:
This is a [better port](https://www.aliexpress.com/item/1PCS-lot-150CM-OBD-II-OBD2-16-Pin-Male-to-Female-Diagnostic-Extension-Cable/1482186322.html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) with a recess we can fill with sealent or a rubber grommet and cap for outdoors?

cheapjack, 2017-04-12:
Closing it's updated in issue #43 now

Closed 2017-04-12.

Thread 34 (2017-03-27):

Waterproof Containers

cefn, 2017-03-27:
The one I bought has since escalated in shipping cost and should not be purchased unless the seller agrees a variation on shipping cost and reprices it before you pay...
https://www.aliexpress.com/item/80-250-85-mm-Size-Newest-And-Hotest-PC-Clear-Cover-Waterproof-Switch-Box-Waterproof-Enclosures/32516362724.html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

However it is a DS-AT-0825 and available from other suppliers https://www.aliexpress.com/w/wholesale-DS%25252dAT%25252d0825.html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

There are other models with different sizes like...

https://www.aliexpress.com/item/DS-AT-0811-80-110-70mm-2014-Newest-Large-IP66-ABS-Waterproof-Switch-Box-IP66-Screw/2055624079.html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,searchweb201602_6_10065_10130_10068_433_434_10136_10137_10138_10060_10062_10141_10056_10055_10054_10059_10531_10099_10530_10103_10102_10096_10052_10144_10053_10050_10107_10142_10051_10143_10526_10529_10084_10083_10080_10082_10081_10110_10111_10112_10113_10114_130_10037_10078_10079_10077_10073_10070_10122_10123_10124,searchweb201603_3,afswitch_1,ppcSwitch_5,single_sort_0_default&btsid=eaf2de66-ce26-4833-80d1-26428ac9791d&algo_expid=2e97d08f-b508-4f3d-9064-669055501e3e-24&algo_pvid=2e97d08f-b508-4f3d-9064-669055501e3e

...or...

https://www.aliexpress.com/item/158mmx90mmx60mm-Wire-Connect-Waterproof-Sealed-Switch-Junction-Box-Clear-Gray/32480361405.html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,searchweb201602_6_10065_10130_10068_433_434_10136_10137_10138_10060_10062_10141_10056_10055_10054_10059_10531_10099_10530_10103_10102_10096_10052_10144_10053_10050_10107_10142_10051_10143_10526_10529_10084_10083_10080_10082_10081_10110_10111_10112_10113_10114_130_10037_10078_10079_10077_10073_10070_10122_10123_10124-10530,searchweb201603_3,afswitch_1,ppcSwitch_5,single_sort_0_default&btsid=8ce2d38b-a91c-4f94-aa71-30acd4b7f8c5&algo_expid=4485747e-96bb-4e43-a218-52f9170e60cc-16&algo_pvid=4485747e-96bb-4e43-a218-52f9170e60cc

You might find other useful model numbers to search for by scrolling through this multi-page search...
https://www.aliexpress.com/wholesale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

I was curious to know if a switch cover like the ones linked below could work for activation of a battery-operated device by lifting, and would fall again by default and close the switch when you released it, assuming the build was in a suitable box, and required a tap on the front - people could open it and then release it - a Normally Closed reed switch and magnet might be feasible, perhaps to eliminate friction in the switch...
https://www.aliexpress.com/item/Transparent-Blue-Waterproof-Box-For-Switch-Socket/32716079907.html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,searchweb201602_6_10065_10130_10068_433_434_10136_10137_10138_10060_10062_10141_10056_10055_10054_10059_10531_10099_10530_10103_10102_10096_10052_10144_10053_10050_10107_10142_10051_10143_10526_10529_10084_10083_10080_10082_10081_10110_10111_10112_10113_10114_130_10037_10078_10079_10077_10073_10070_10122_10123_10124-10530,searchweb201603_3,afswitch_1,ppcSwitch_5,single_sort_0_price_asc&btsid=46a453bb-e37c-471e-b6af-65a652ae9609&algo_expid=5208d710-d1d8-4685-95bb-4046e913315c-32&algo_pvid=5208d710-d1d8-4685-95bb-4046e913315c

https://www.aliexpress.com/item/Home-Mounted-Switching-Power-Supply-Panel-86-Mounted-White-Waterproof-Socket-Flip-Waterproof-Box-Panel-PC/32789801690.html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,searchweb201602_6_10065_10130_10068_433_434_10136_10137_10138_10060_10062_10141_10056_10055_10054_10059_10531_10099_10530_10103_10102_10096_10052_10144_10053_10050_10107_10142_10051_10143_10526_10529_10084_10083_10080_10082_10081_10110_10111_10112_10113_10114_130_10037_10078_10079_10077_10073_10070_10122_10123_10124-10531,searchweb201603_3,afswitch_1,ppcSwitch_5,single_sort_0_price_asc&btsid=9a964ce2-fd09-4289-819c-68d58d7fed23&algo_expid=69c8b7d2-2070-4f29-9919-c15865e761fc-13&algo_pvid=69c8b7d2-2070-4f29-9919-c15865e761fc

cheapjack, 2017-03-28:
Sorry didnt checkout github this morning.. durr
I found
This [IP66 Box of good dimensions](https://www.aliexpress.com/item/Low-shipping-cost-high-quality-ip66-plastic-enclosure-box-with-transparent-lid-140-170-95mm/1708264367.html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) 170mmx140mmx95mm (W,D,H) at $17.44

cheapjack, 2017-03-28:
I've been looking at this size W 140mm x Depth 170mm x Height 95mm: it fits everything in nicely with flexibility etc.

Also [this explaination of IP ratings](http://www.dsmt.com/resources/ip-rating-chart/) was useful

cheapjack, 2017-03-29:
Heres the footprint of components to scale using [this box's outer dimensions](https://www.aliexpress.com/item/Low-shipping-cost-high-quality-ip66-plastic-enclosure-box-with-transparent-lid-140-170-95mm/1708264367.html) **W 140mm x Depth 170mm x Height 95mm**

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

cheapjack, 2017-03-29:
Worth noting could not find datasheet for this box, so Ive made generous inner dimensions going on images on the item page

cheapjack, 2017-03-29:
Obviously the RFID reader would be positioned below the screen ive just moved it to the side so you can see measurements clearly. All measurements pretty accurately measured with calipers (apart from box)

cheapjack, 2017-03-29:
Should be plenty of clearance to drill a grommet for the power input on the bottom side and can see how headers can be arranged sensibly. Will laser cut a net to position components correctly, use threaded/nuts/spacers/bolts to keep it all vertically aligned also. Can see some threaded mounting points internally inside [this box](https://www.aliexpress.com/item/Low-shipping-cost-high-quality-ip66-plastic-enclosure-box-with-transparent-lid-140-170-95mm/1708264367.html), so at least one or 2 threaded points would be a good idea internally for any box we choose.

cheapjack, 2017-04-06:
Lets use [this one](https://www.aliexpress.com/item/Low-shipping-cost-high-quality-ip66-plastic-enclosure-box-with-transparent-lid-140-170-95mm/1708264367.html)

Closed 2017-05-18.

Thread 35 (2017-03-28):

Get Outdoor Battery power components and solutions

cheapjack, 2017-03-28:

cheapjack, 2017-03-28:
This [panel mount usb](https://www.aliexpress.com/item/New-Brand-Micro-USB-B-panel-mount-male-to-female-extension-cable-M-F-USB2-0/32663445804.html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) is ok for connecting up power into the IP66 Box or this much [cheaper one](https://www.aliexpress.com/item/1PCS-lot-150CM-OBD-II-OBD2-16-Pin-Male-to-Female-Diagnostic-Extension-Cable/1482186322.html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) which has a space for silicon sealing

cheapjack, 2017-03-28:
I bought and tested [this external non outdoors battery](http://www.ebay.co.uk/itm/232210843823) and seems similar to [these](http://www.ebay.co.uk/itm/Portable-External-12000mAh-USB-Power-Bank-Battery-Charger-For-Mobile-Phone-Tab/351942901523)

cheapjack, 2017-03-28:
This is similar to [the waterproof solar battery](http://www.ebay.co.uk/itm/100000mAh-Solar-Power-Bank-USB-Portable-Battery-Charger-Panel-for-iPhone7-iPad/162285808334) I tested earlier (it powers on connection, turns off when disconnected)

cheapjack, 2017-03-28:
@cefn [this looks even better](http://www.ebay.co.uk/itm/50000mAh-USB-Portable-External-Battery-Solar-Power-Bank-Dual-Charger-High-Power/122383844777) but untested

cheapjack, 2017-03-29:
[This?](https://www.aliexpress.com/item/BYLYND-Solar-Power-Bank-20000mAh-Double-USB-Solar-charger-External-Battery-Portable-Charger-Bateria-Externa-Pack/32751232253.html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,searchweb201602_2_10152_10065_10068_10130_10150_10136_10137_10060_10138_10062_10141_203_10056_10055_10054_10059_10099_10103_10102_10096_10144_10052_10053_10142_10107_10050_10143_10051_10525_10529_10084_10083_10080_10082_10081_10110_10111_10112_10113_130_10114_10516_10515_10037_10078_10079_10077_10073_10070_10122_10123_10124-10150_10152_10516,searchweb201603_1,afswitch_1,ppcSwitch_5,single_sort_0_default&btsid=44650578-7974-43c0-be80-25146f12667f&algo_expid=dade4e72-bf6c-411e-8da1-b79e596618f9-0&algo_pvid=dade4e72-bf6c-411e-8da1-b79e596618f9)

cefn, 2017-03-29:
Reference [https://www.aliexpress.com/item/BYLYND-Solar-Power-Bank-20000mAh-Double-USB-Solar-charger-External-Battery-Portable-Charger-Bateria-Externa-Pack/32751232253.html](the suggested screw-fit female USB micro socket) Is there any reason not to just use a regular cable from the inside of the box to the outside (e.g there's a Male A-type which comes out of the box). I am guessing we will have to improvise extensions in many cases anyway depending on where the power supply is, so I'm not sure what advantage this gives us, relative to simply attaching a retainer to the cable so it can't be pulled out?

Closed 2017-04-06.

Thread 36 (2017-03-28):

Soft latching circuit

cefn, 2017-03-28:
https://www.pololu.com/product/2808 could be a complement for the USB battery pack, preserving power by being triggered by NC (normally closed) reed switch mounted on cover.

cheapjack, 2017-03-29:
👍

cheapjack, 2017-04-04:
Include 2 3M mounting holes for the circuit and incorporate reed switch from the breadboard to the outer skin where it would make contact with the mounted swing-cover, the magnet inset on the inside of the lasercut acrylic bent cover via an IP66 grommet

Closed 2017-05-18.

Thread 39 (2017-03-30):

Write Final Games in avatap

gkboulter, 2017-03-30:
Final 6 museums / games to write:
**Corbridge
Housesteads
Arbeia
Segedunum
Senhouse
Tullie House**

Aiming to complete first drafts of:
**Corbridge / Housesteads / Segedunum** week (ending 31/3/17)
Then **Tullie House / Arbeia** week ending 7/4/17
Finalise / checking **all** during week ending 14/4/17
also can work with Ross on **Senhouse** if help needed

cheapjack, 2017-03-30:
Great, also Barbara confirmed they do not want to pursue vindolanda on Monday will respond to her tomorrow and give an update to Lisa. Been focussing on boxes.

cheapjack, 2017-04-12:
@gkboulter email to me I mean :)

gkboulter, 2017-04-12:
sent them over yesterday to you - will send again now :)

cheapjack, 2017-04-12:
Just seen you've already sent them sorry email hadn't refreshed 👍

gkboulter, 2017-04-19:
**Tullie House - Box placements**

@cheapjack have used your original box definitions (**I - fort, II - arena entrance, III - arena**) plus a fourth box which at the minute is the **IV - garrison** (base area).

Map using the positions we penciled in during visit - all next to power points:

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

**I - **FORT**** South wall at gallery entrance immediately to right of door (rideable horse is in this area too)
**II - **ARENA ENTRANCE**** South wall / middle section
**III - ARENA**: South wall / Projection area
**IV - GARRISON:** North wall / middle section

Will send over game in progress this am, just fixing some bits.

gkboulter, 2017-05-02:
Making a final check through of **Corbridge** and **Housesteads** games today ready for Thursday install. @cefn - could you advise whether I need to make any changes other than fixing bugs etc? (eg reducing no. of passages)

cheapjack, 2017-05-03:
@gkboulter just send me the game files as they are now so I can push them to my repo @cefn can build an integration test image tonight for tomorrows assembly

Closed 2017-05-18.

Thread 40 (2017-04-01):

Estimate power usage for outdoor battery boxes

cheapjack, 2017-04-01:
Got about 29 hours out of a cockle in a tiny ip68 box serving WiFi with no power restrictions or sleep, the last hour I connected to WiFi and got it to turn an 8x8 RGB LED Neo pixels off and on using a 50000mahr battery. By no means a proper test but if we have no Wi-Fi and the switch off circuit we could get them to last a while... Will try time it with screen powered next

cheapjack, 2017-04-07:
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

I got approx 10 hours overnight out of the Dizaul (closest reference to the [solar battery packs](http://www.ebay.co.uk/itm/Waterproof-12000mAh-Solar-Battery-Quick-Charger-Power-Bank-Pack-For-Mobile-Phone/262902644680) on order, with screen (green versio) and the [RFID-RC522](http://www.electrodragon.com/product/mifare-rc522-rfid-card-readerdetector-ic-card/) both powered from the cockle inside the assembed indoor box prototype

Closed 2017-05-18.

Thread 41 (2017-04-04):

Design and order printed maps & RFID stickers

gkboulter, 2017-04-04:
Glenn to design layout week of 10th April.
Order no later than Weds 19th to receive in time for install.
Current price from Printed.com
Size 210 x 210 2xside colour print 	1000  £289.26 	inc delivery 	0.29 p/unit

gkboulter, 2017-04-04:
Content to include:

- Cover image / sprite(s)
- Simple diagram of participating museums along wall
- What is Milecastles?
- How to play inc. how to tap correctly diagram
- Image of box design so players know what to look for
- Link to website (if applicable)
- Credits
- Logos / Hadrian's branding (from Lisa)

gkboulter, 2017-04-05:
Will design stickers for RFID cards in same time frame as above with maps.

cheapjack, 2017-04-06:
How to play as family
How to use outdoor boxes lift up lid
Leave out schools

cheapjack, 2017-04-07:
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
Sticker size ref, 23mm diameter sticker would fit within inner groove with about 0.25mm to spare

gkboulter, 2017-04-12:
Sticker previews - thinking the cropped face detail might have most impact as it's quite a small area to see the full figure or face. Plus full figure will be on the map...

23mm diameter sticker options:

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

cheapjack, 2017-04-12:
Yeah i like the cropped face best esp. if the full figure in print will look at that in a mo trying to debug a weird thing in arebia I found; I love the game though!

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

gkboulter, 2017-04-12:
Link to Map text document - feel free to make edits / changes
https://docs.google.com/document/d/17_eXBXt8rOXjsexcWzBKKhLQ35fpZFGv4Q1RKYhkbaA/edit?usp=sharing
I need to get final design signed off by Lisa as soon as we're happy with layout - pdf to follow this pm.

gkboulter, 2017-04-12:
Map designs so far -   still need to:
- Redraw the map in 8 bit style (current one is placeholder)
- Get rid of some outlines etc on images and logos.
- Add other facial expressions from animated soldier
- Finalise text
- Finalise box image with @cheapjack if any major changes
- Spin top half of front page 180degrees so that it reads like a booklet when folded

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

cheapjack, 2017-04-12:
Lovely design Glenn! Have updated text in the doc so changing cards to tags

- Show some kind of drawing of tag (with arrow?) being placed against a box in **WHAT IS MILECASTLES**
- In **WHERE TO PLAY** Some kind of helpful drawing? Tap diagram in extreme close-up?

Reference for [box image](https://github.com/cheapjack/MileCastles/blob/master/boxes/BoxForMap.pdf)

gkboulter, 2017-04-12:
Stickers ordered - got 2,000 units in the end as min order was £50.
Waterproof/scratchproof/high tack
Arriving Tues/Weds - will bring to Liverpool on Weds/Thurs.

gkboulter, 2017-04-13:
Updated design - sent to Lisa for approval. Aiming to send to print today as soon as it comes back.

Added:
- Tapping Instructions
- New wall map w/ key in same panel
- New box image
- Updated text from google doc (trimmed for space in a couple of places)

Still to do:
- Clean edges of Unesco logo
- Final proof reading of text

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

gkboulter, 2017-04-13:
Ordered 100 x maps and 20 square display panel images so that we have some for next week.
Arriving with GB on Weds so will bring over to @cheapjack on Thurs.
Will order full 1,000 units when Lisa has signed off.

Latest proofs:

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

gkboulter, 2017-04-19:
- Printed maps approved by Lisa Keys 19/4/17
- GB to show to proofs to @cheapjack and @cefn for feedback at meeting on 20/4/17
- Look at ways of mounting the display panel/image
- Suggest we go with a slightly lighter weight paper for the maps to make folding easier.
- Aiming to order full print run on 21/4/17
- GB to apply stickers and fold batches of maps in prep for each installation

gkboulter, 2017-04-21:
Updated text document for MAP with changes from yesterday's meeting:
https://docs.google.com/document/d/17_eXBXt8rOXjsexcWzBKKhLQ35fpZFGv4Q1RKYhkbaA/edit?usp=sharing

To do before final print run:
- @cefn and @cheapjack to comment on instruction text
- GB to change text in final layout
- GB to add 'horse' tap area to box images

cheapjack, 2017-04-22:
Im not convined by a horse logo to represent the interaction I think some kind of wifi/nfc related thing is more universal. Ive pushed a milestone back for this to 1st May to get final print together. Also @hwayounggit had some suggestions so I'm adding her to the project so she can help with this, documentation of builds and installs etc. She's coming with us to Corbridge on the 5th

gkboulter, 2017-04-24:
Just checked and we need to complete any print changes by **Thurs 28/ Fri 29** to receive the order in time to take to Corbridge on the 5th May. The bank holiday is adding an extra day onto order times again(!). I'll also need to do some folding on 4th so that we aren't trying to do it on the day.

hwayounggit, 2017-04-24:
Print Comments:
**Overall**
- Need red dotted lines? Seems unnecessary also causes nightmare when folding and not aligned.
- Can the the typeface for the logo - the Roman looking font be a thicker weight? At least for the title. Seems a bit slight
**How to Play page**
Wonder if the How to Play should be on the right and What is Milecastles should be on the left...
- point ii - to read Box I (Roman Numberals) instead of #1 - can be confusing.
- point iii - 'Tap' is in quotes and is 'read point'. Think Tap should be **bold** or some other way of distinguishing the text from 'read' point'. Two different things
- iv - e.g. 'Go to Box IV' should be in TextTextFont.
**What is**
- Can the sample yellow boxes be a bright yellow, like the one on the 'How to Tap' yellow?
**Where to play**
- the circles with the i, ii, iii etc can they be little forts AND change the font from TeleText to something else. It's confusing. Think adding forts will reinforce the idea that it's Hadrians Wall. Didn't get that. Love the little bitmap centurion
- the red panel with the information looks funny being aligned right. Any reason for that? Would align to the full stops after the numerals.
**How to Tap**
- Don't think you need the : after How To Tap
- Can the circle with the centurion sticker be the shape of the fob?
**Tips and hints**
- Feel like you need a direct instruction/tip in the yellow and then the text that expands. For example: i Play as a group(yellow) We recommend etc...
ii Persevere (yellow) If you don't ...
iii Keep your tag (yellow) Go to any of the six ...
iv Be gentle (yellow) Pressing harder on the boxes will not help you the goddess Minerva will curse you!
**Credits**
- Check the Hadrian's Calvary logo. Bit snipped on the right.

cefn, 2017-04-24:
I've been posting changes into the doc and extensively commented. Hopefully that radically shortens text for the punchy intro, and also has a suggestion for re-allocating the 'what is milecastles' panel to be the graphical intro (e.g. the moment you open, on the left you see punchy text instructions, on the right you see the corresponding imagery).

gkboulter, 2017-04-25:
Thanks for the feedback @hwayounggit - all really useful!!
Have updated all the text and added changes above - just need to add the updated 'tag circle' box image from @cheapjack then will share.
Aiming to go to print end of day tomorrow / 25th April.

cheapjack, 2017-04-25:
Glenn I've added the [BoxForMap.pdf](https://github.com/cheapjack/MileCastles/blob/master/boxes/BoxForMap.pdf) Ref, look out though ive not got a vector version of the roman face so ive got a placed png object in the pdf. Updated to have the original logo not infilled but still present you may want to remove so it wont glitch the print process when you export for print.

I'll go through and resolve the comments in the [gdoc](https://docs.google.com/document/d/17_eXBXt8rOXjsexcWzBKKhLQ35fpZFGv4Q1RKYhkbaA/edit?usp=sharing) tomorrow

cheapjack, 2017-04-25:
Should be able to proof and resolve everything tomorrow.

gkboulter, 2017-04-25:
Thanks @cheapjack will add the new box images in tonight and preview the new layout here.

gkboulter, 2017-04-25:
Latest proof, with:
- Text updated from gdoc,
- Changes suggested by Hwa Young
- New box images with tag circle

Front:

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

Front (flipped)

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

Back:

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

cheapjack, 2017-04-27:
additional comments for @gkboulter to sign off his print
- Remove the space between `Domestic` and `Science.org.uk` so its more like a webaddress (which it is of course)
- Keep 'USING YOUR TAG' over 'HOW TO TAP'
- Change role-play to ROLE-PLAY capitals to refer to the capitals in the game?
- Hwa Young suggested back colour a deeper royal blue to match to the blue in the boxes? to be honest Im not sure the print will look as nice and a direct match could spoil it. We just couldnt find enough acrylic to match the blue. Worth noting the blue in the boxes will be almost totally hidden in most cases so I think the current colour scheme which is not a match is fine. Image below shows difference and i dont think matching them will give much benefit.

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

cheapjack, 2017-04-27:
Sorry for being so late @gkboulter with this! Cant easily see where a diagram of lifting the lid can be incorporated. Currently considering a tinted acrylic lid so you can still see the same 'skin'.
Ive suggested adding `LIFT LID on boxes OUTDOORS` and removing the parantheses underneath point `iii` in the HOW TO PLAY panel which I think covers this. Capitals in yellow capital font as in the rest

cheapjack, 2017-04-27:
Ill be in Morecambe at 1030 so should we do quick final proof then? I can talk on the journey up over bluetooth.

gkboulter, 2017-04-27:
Just making changes now - any time from 10:30 good to do quick proof over phone!

cefn, 2017-04-27:
I had hoped that given How to Play includes the relevant _text_ guidance, that the panel immediately to the right (currently titled 'Using your Tag') was redundant in that form, meaning the panel could be dedicated to graphical depictions of the parts of the system. That's 60% of what it is doing already, but by dropping the "Using your Tag" element and the guidance text, and instead focusing on graphical depictions you could potentially have a pictorial 'frame' showing placing the tag, a second 'frame' depicting text on screen, and a frame depicting outdoor lid opening, possibly a fourth frame for anything else we want to depict (is there a way to depict mime? that's a challenge for you!).

I'm really shy of doing a big print run at this stage. We haven't even nailed the final interaction sequence, which will only be finally settled by a few days of testing, (e.g. do you remove to wait for the text or not), yet we're baking our provisional implementation into potentially a large number of leaflets.

I fear we may regret it, given a disjoint between the instructions and the actuality could be messy and need explanation, defeating the purpose of the leaflet. Requiring ourselves to design the interaction to match the leaflet is very heavily the wrong way round.

gkboulter, 2017-04-27:
Some stickered tags for reference:

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

cefn, 2017-04-27:
They look just right! Based on my rule of thumb of 2x Foundation Living Wage for manual labour activities and the estimate of time taken for 100 you gave today, (unless you find a much more efficient way of sticking them), we should charge the sticking at about £16.90 per 100, on top of the sourcing and printing. Roughly 17 pence each. Could some kind of laser-cut jig help, which can accept e.g. 50 tags in the right orientation, making the alignment+sticking part easier?

gkboulter, 2017-05-02:
Latest batch of print received (400 copies of map) for Crobridge / Housesteads install on Fri 5th.
Will fold as many as possible before Fri - lower paper weight folds much more easily.

gkboulter, 2017-05-05:
GB to add final instructions in response to play test (eg loading times / safety advice on tag as choke hazard) on **Monday 8th May.** to receive final print run in time for installs.

gkboulter, 2017-06-02:
Latest draft of print design.

Have updated:
- About / Prize draw text (prize tbc)
- Map key with instructions to check off museums
- Hints and Tips - added choke hazard warning

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

- Instruction text
- How to use tag - text update (image being updated now

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

cheapjack, 2017-06-02:
## HOW TO PLAY
change TAG CIRCLE to TAG SYMBOL
LIFT TAG or REPLACE TAG to LIFT TAG or PLACE TAG message

## USING YOUR TAG
PLACE your tag
for a few seconds to
load game from tag
until LIFT or PLACE
message appears
?

gkboulter, 2017-06-02:
Updated maps (aiming to print early next week if possible) - would be good to get your feedback @cefn!

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

cefn, 2017-06-02:
I've separated the instructions about gameplay and tags in this draft. Hope it's helpful and not two steps back. The text below is based on the latest interaction and capitalises only the imperative phrases. It's designed to make it feel

# HOW TO PLAY

i) FIND BOX 1 and PLACE YOUR TAG flat on tag symbol
ii) READ PAGE, MIMING ANY ACTIONS (no cheating!)
iii) FOLLOW INSTRUCTIONS on-screen
iv) DISCOVER YOUR ENDING
v) PLAY AGAIN to discover different endings

# USING YOUR TAG

i) LIFT LID for outdoor boxes
ii) PLACE TAG on tag symbol to load a page
iii) HOLD IN PLACE until bookmark saved
iv) REMOVE TAG when finished reading the page
iv) REPEAT ii) iii) iv) until choice page presented
v) GO TO BOX matching your chosen action

gkboulter, 2017-06-05:
Thanks @cefn  - am updating the layout today

cheapjack, 2017-06-05:
Just for consistency here's the proof of those updates @gkboulter did tonight

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

cefn, 2017-06-05:
These look totally brilliant! Well done @gkboulter !

Only one last tweaky comment. I think the TIPS AND HINTS section could easily drop the i) ii) iii) metaphor since they are not naturally ordered and it would allow punchier presentation (more whitespace, more text or bigger text in that box), as well as enabling the i) ii) iii) metaphor to have better impact elsewhere. At present I think it struggles a little with the multiple indentation and duplicate color heirarchy as per the original How to Play but nowhere near as important to fix, given these tips are a 'bonus' panel.

cheapjack, 2017-06-06:
Yes I'd agree on that.

gkboulter, 2017-06-07:
Lisa has suggested she can offer a DS as a prize - should we still push for Microbits?

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

Updated Hints and Tips section:

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

cefn, 2017-06-07:
Anything will be fine. However, a DS sounds better doesn't it (and more in theme with young gaming enthusiasts). Perhaps Microbits as runner up. Can we park this with weasel text in the guide, like "amazing prizes" which might make people go to the URL anyway to find out?

gkboulter, 2017-06-12:
Updated prize text -

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

cheapjack, 2017-06-12:
Updated prize text looks good to me!

gkboulter, 2017-06-12:
Final run - ordered 1200 copies (200 per site) - £209
Arriving Weds 14th June with Glenn

gkboulter, 2017-07-06:
Updated maps to correct Housesteads / Corbridge mix up.
200 x copies sent to Corbridge for Monday 10th July
GB to order 800 new maps for remaining 4 installs and fold in time for 17/18th Juy.

Closed 2017-07-09.

Thread 43 (2017-04-05):

Confirm all components are on order/being made/sourced

cheapjack, 2017-04-05:
# Interactions

I think we should go with the RFID tags over cards with nice MileCastles Sticker

|Item|Ordered|Sourced|Made|Blame
|----|----|----|----|----
|RFID cards #4 **NO** |<ul><li>[ ] </li>|<ul><li>[ ] </li>|<ul><li>[ ] </li>|Ross
|RFID tags [with this reader](http://www.electrodragon.com/product/mifare-rc522-rfid-card-readerdetector-ic-card/) **YES**|<ul><li>[x] </li>|<ul><li>[ ] </li>|<ul><li>[ ] </li>|Cefn
|MileCastle round Cavalryman Sticker|<ul><li>[ ] </li>|<ul><li>[ ] </li>|<ul><li>[ ] </li>|@gkboulter

# Boxes Minimum
**17 internals**
**6 externals**

## Externals for on-grid & off-grid boxes
|Item|Ordered|Sourced|Made|Blame
|----|----|----|----|----
|Clear inset acrylic to protect screen (?)|<ul><li>[ ] </li>|<ul><li>[ ] </li>|<ul><li>[ ] </li>|Ross
|Decorative acrylic for Outer Case Designs|<ul><li>[x] </li>|<ul><li>[x] </li>|<ul><li>[ ] </li>|Ross
|Internal acrylic material|<ul><li>[x] </li>|<ul><li>[x] </li>|<ul><li>[ ] </li>|Ross
|M6 10mm for lid socket|<ul><li>[ ] </li>|<ul><li>[ ] </li>|<ul><li>[ ] </li>|Ross
|M6 70mm [Coach bolts](http://www.ebay.co.uk/itm/191920495458)|<ul><li>[x] </li>|<ul><li>[x] </li>|<ul><li>[ ] </li>|Ross
|M6 100mm [Coach bolts](http://www.ebay.co.uk/itm/191920495458) for off-grid boxes|<ul><li>[x] </li>|<ul><li>[x] </li>|<ul><li>[ ] </li>|Ross
|M6 120mm [Coach bolts](http://www.ebay.co.uk/itm/191920495458) for off-grid boxes|<ul><li>[ ] </li>|<ul><li>[ ] </li>|<ul><li>[ ] </li>|Ross
|M6 nuts|<ul><li>[x] </li>|<ul><li>[x] </li>|<ul><li>[ ] </li>|Ross
|M6 nut covers|<ul><li>[x] </li>|<ul><li>[ ] </li>|<ul><li>[ ] </li>|Ross
|M6 washers|<ul><li>[ ] </li>|<ul><li>[ ] </li>|<ul><li>[ ] </li>|Ross

## Internals for On-grid Boxes
|Item|Ordered|Sourced|Made|Blame
|----|----|----|----|----
|Headers & dupont connectors|<ul><li>[ ] </li>|<ul><li>[x] </li>|<ul><li>[ ] </li>|Cefn
|400 point breadboard|<ul><li>[ ] </li>|<ul><li>[x] </li>|<ul><li>[ ] </li>|Cefn
|Micropython Cockle|<ul><li>[ ] </li>|<ul><li>[x] </li>|<ul><li>[ ] </li>|Cefn
|90 degree headers for screens|<ul><li>[ ] </li>|<ul><li>[x] </li>|<ul><li>[ ] </li>|Cefn
|[RFID-RC522](http://www.electrodragon.com/product/mifare-rc522-rfid-card-readerdetector-ic-card/) Read/Writers|<ul><li>[x] </li>|<ul><li>[x] </li>|<ul><li>[ ] </li>|Cefn
|128x64 White Backlit LCD pixel screens|<ul><li>[x] </li>|<ul><li>[ ] </li>|<ul><li>[ ] </li>|Cefn
|[Panel mount internal micro-USB-B extension](https://www.aliexpress.com/item/1PCS-lot-150CM-OBD-II-OBD2-16-Pin-Male-to-Female-Diagnostic-Extension-Cable/1482186322.html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) from micropython cockle port|<ul><li>[x] </li>|<ul><li>[ ] </li>|<ul><li>[ ] </li>|Ross

## Externals for Off-grid Boxes
|Item|Ordered|Sourced|Made|Blame
|----|----|----|----|----
|Internal & External Fixings for side/rear fixing to fence posts/signs|<ul><li>[ ] </li>|<ul><li>[ ] </li>|<ul><li>[ ] </li>|Ross
|Battery Pack bracket on reverse: additional through hole fixings|<ul><li>[x] </li>|<ul><li>[ ] </li>|<ul><li>[ ] </li>|Ross
|Box acrylic bent wings for lid socket|<ul><li>[ ] </li>|<ul><li>[ ] </li>|<ul><li>[ ] </li>|Ross
|Adjust skin for lid|<ul><li>[ ] </li>|<ul><li>[ ] </li>|<ul><li>[ ] </li>|Ross
|Tinted acrylic Lid with inset magnet|<ul><li>[ ] </li>|<ul><li>[ ] </li>|<ul><li>[ ] </li>|Ross
|USB Charger port/cable & reed switch lines [grommet plug shell cap cover](https://www.aliexpress.com/item/6-Pieces-Waterproof-Aviation-Connector-Plug-Shell-Cap-Cover-for-GX16/2053433214.html) |<ul><li>[x] </li>|<ul><li>[ ] </li>|<ul><li>[ ] </li>|Ross
|MicroUSB-B (cockle) extension to exiting USB-A via IP66/8 grommet|<ul><li>[ ] </li>|<ul><li>[ ] </li>|<ul><li>[ ] </li>|Cefn
|Exiting USB-A to an external solar battery pack|<ul><li>[ ] </li>|<ul><li>[ ] </li>|<ul><li>[ ] </li>|Cefn
|[USB Solar battery Pack](http://www.ebay.co.uk/itm/Waterproof-12000mAh-Solar-Battery-Quick-Charger-Power-Bank-Pack-For-Mobile-Phone/262902644680)|<ul><li>[x] </li>|<ul><li>[ ] </li>|<ul><li>[ ] </li>|Cefn

## Internals for 6 Off-grid Boxes
|Item|Ordered|Sourced|Made|Blame
|----|----|----|----|----
|IP66/8 grommet|<ul><li>[x] </li>|<ul><li>[x] </li>|<ul><li>[ ] </li>|Ross
|reed switch & magnet|<ul><li>[ ] </li>|<ul><li>[x] </li>|<ul><li>[ ] </li>|Cefn
|[IP66/68 Rated Waterproof Boxes](https://www.aliexpress.com/item/Low-shipping-cost-high-quality-ip66-plastic-enclosure-box-with-transparent-lid-140-170-95mm/1708264367.html)|<ul><li>[x] </li>|<ul><li>[ ] </li>|<ul><li>[ ] </li>|Cefn
|Headers & dupont connectors|<ul><li>[ ] </li>|<ul><li>[x] </li>|<ul><li>[ ] </li>|Cefn
|90 degree headers for screens|<ul><li>[ ] </li>|<ul><li>[x] </li>|<ul><li>[ ] </li>|Cefn
|400 point breadboard|<ul><li>[ ] </li>|<ul><li>[x] </li>|<ul><li>[ ] </li>|Cefn
|Micropython Cockle|<ul><li>[ ] </li>|<ul><li>[x] </li>|<ul><li>[ ] </li>|Cefn
|[RFID-RC522](http://www.electrodragon.com/product/mifare-rc522-rfid-card-readerdetector-ic-card/) Read/Writers|<ul><li>[x] </li>|<ul><li>[x] </li>|<ul><li>[ ] </li>|Cefn
|128x64 White Backlit LCD pixel screens|<ul><li>[x] </li>|<ul><li>[ ] </li>|<ul><li>[ ] </li>|Cefn

:robot:
:scroll:

cheapjack, 2017-04-05:
Thought we could start ticking stuff off and have a central list of what we need

cheapjack, 2017-04-06:
Re-counted minimume boxes
17 indoor
6 outdoor

cheapjack, 2017-04-07:
One of the off-grid boxes is actually indoors at Segedunum but with no access to power so potentially another non-solar battery with a bigger mAh output and slimmer profile could be mounted nearby (though weve acknowledged these mAh claims can be arbitrary

Closed 2017-05-18.

Thread 46 (2017-04-09):

Confirm numbers of RFID tags to match sticker print run

cheapjack, 2017-04-09:

gkboulter, 2017-04-12:
Planning to order 1500 x 23mm or 20mm diameter stickers to go with **1,000** RFID tags.
It's cheaper to order 500 spare stickers now (£5 or so) in case we need further tags later on.

cheapjack, 2017-04-12:
Cool! Id go with the 1500 x 23mm which is a perfect fit for the tag I got from @cefn that i referenced [here](https://github.com/cheapjack/MileCastles/issues/41#issuecomment-292514955)

cheapjack, 2017-04-12:
double checked 23mm diameter is a good fit for that tag 👍

gkboulter, 2017-04-12:
Going with a different printer for these that does custom sizes as existing one (printed.com) will only do 25mm. These will do custom size next day delivery: http://www.discountstickerprinting.co.uk with anti scratch lamination for approx £25-£30

cheapjack, 2017-04-12:
Lamination just might give it that nice gift shop keyring feel so Id go with that. If we were printing RFID cards the print costs on that would have been much bigger so this is still cheap

gkboulter, 2017-04-24:
We have **1900** stickers on hand so will cover the initial 1,000 tags plus a top up of 900 if we need to restock the tags at a later date.

Closed 2017-06-27.

Thread 47 (2017-04-12):

Adjust rightmost through holes for the skin to fit

cheapjack, 2017-04-12:
Weirdly all the rightmost through holes shifted 2mm down and 0.5 mm across; adjust completed skin cuts

cheapjack, 2017-04-13:
Actually resolved without cutting

Closed 2017-04-13.

Thread 49 (2017-04-12):

Buy the mountings to let interior boxes tilt down or up with acrylic bent fixing tab

cheapjack, 2017-04-12:

Closed 2017-04-13.

Thread 53 (2017-04-13):

Buy extra M4 nuts & washers, M4 x 5mm, M4 x 12mm bolts for angled or flush fixings

cheapjack, 2017-04-13:

cheapjack, 2017-04-17:
## Each indoor box:
## On-box
### Angled fitting option
- [ ] 6 M4 nuts per angled fixing pair
- [ ] 2 M4 x 12mm bolts per angled fixing pair
### Flush fitting
- [ ] 8 M4 nuts per flush fitting pair
- [ ] 8 M4 washers per flush fitting pair
- [ ] 8 M4 x 5mm countersunk machine screws
## On Wall
9 M4 countersunk screws and plugs for masonry
9 M4 countersunk screws and plugs for plasterboard
9 M4 countersunk screws and plugs for wood/mdf

Closed 2017-05-05.

Thread 54 (2017-04-15):

3d print 46 brown tiles as cap nuts with internal M6 hex nut fitting

cheapjack, 2017-04-15:

cheapjack, 2017-04-17:
Print [hex_nut_tile_cap.stl](https://github.com/cheapjack/MileCastles/blob/master/boxes/hexnut_tile_cap.stl) in brown PLA/ABS

cheapjack, 2017-04-22:
30 ready at 21/04/17

Closed 2017-05-18.

Thread 56 (2017-04-17):

Review the solar battery supplies

cheapjack, 2017-04-17:
@cefn killed a cockle with the currently sourced supply; review this and check if we need replacements from UK seller possibly

Closed 2017-05-18.

Thread 57 (2017-04-17):

Confirm the text fonts for cefn

cheapjack, 2017-04-17:
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

I think [tim08](https://github.com/cheapjack/MileCastles/blob/master/screens/fonts/timR08.png) should be the main text. I've mocked up its spacings above in a 5x7 font I had which is a good fit. Worth noting that capitalisation takes up more than 5x7. 8x7 in most cases except for capital `M` which is 9x7. As a result, @gkboulter when using capitals for the ACTING out text I would allow for this with extra character spacings. In the above case its fine

I think use [timB12](https://github.com/cheapjack/MileCastles/blob/master/screens/fonts/timB12.png) for the extra big **first landing text** described in #37 and the **idle text** described in #30

For TAP TO CONTINUE & Goto III and other capitals inversed as part of the interaction text described [here](https://github.com/cheapjack/MileCastles/issues/29#issuecomment-287317741) we'd still use the capitals in [tim08](https://github.com/cheapjack/MileCastles/blob/master/screens/fonts/timR08.png)

cheapjack, 2017-04-17:
Picked tim08 because it looks nice and makes me think of times new roman and also is right size to give us those 9 lines of 26 characters we've been working to, although we'll need to allow for the capitals taking up more horizontal pixels

cefn, 2017-04-18:
Not sure that mocking up with a different font will give you much of an idea how it presents I'm afraid. To test this out you'd have to use the font itself. You could use and tweak the Pillow render routine of https://github.com/ShrimpingIt/bitfont to validate pixel-for-pixel.

cefn, 2017-04-18:
This is what it looks like...

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

cefn, 2017-04-18:
However, it comes out at approx 9 pixels high, which is why we need to check against the real fonts. You can't have TimR08 and still hit the dimensions you're hoping for.

cefn, 2017-04-18:
By comparison, this is the font_5x7 which I've been using for testing - 7 pixels high even with the proper line spacing...

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

cefn, 2017-04-18:
How many pixels high are you expecting individual characters to be in the 'extra big' text? Based on the examples I saw, it would be 2 lines high, therefore 32 pixels. For that reason it's not the best idea to use a 12 pixel high font I feel, even drawn with double pixels.

There are others which are bigger and will render at a large size. Alternatively something which is a divisor of 32 (e.g. 16 or 8) would be able to be scaled to fill and be large as possible, though I don't have any scaling routines yet.

```helvB08``` for example is actually 11 pixels high, meaning it could scale to 33 pixels high. ```ncenB10``` renders at 18 high, but is actuall 16 plus a lot of space above. So far the ideal one, though, seems to be ```ncen24B```. I made a test render for CAPS only, (which cuts off the descenders from the lower case letters). It is exactly 32 pixels high! See below...

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

cefn, 2017-04-18:
Having said all that, I have a fear that our memory limits will force us to avoid high-res fonts, so scaling could be the only way to go. Hitting a brick wall on memory at the mo. Everything else is go.

cheapjack, 2017-04-19:
Ok scrub my suggestions no worries;  if memory is solved and we can use these fonts can we just use the `font_5x7` you mention you've used for testing [above](https://github.com/cheapjack/MileCastles/issues/57#issuecomment-294735834) and then the `ncen24B` for caps?

Closed 2017-05-05.

Thread 59 (2017-04-19):

Adjust the apertures for the panel mount power

cheapjack, 2017-04-19:
predictably order of panel mount usb is slightly out by 1mm : bring the apertures closer together on the x axis by 1mm

Closed 2017-04-19.

Thread 61 (2017-04-19):

Cable clip fixings to keep usb power-mains power neat and tidy

cheapjack, 2017-04-19:

Thread 62 (2017-04-20):

Hardware taken by Ross/Glenn - 20th April and 9th May

cefn, 2017-04-20:
# 20th April

MFRC522 RFID Readers (1tag+1credit card ea.) - 25pcs supplied
12864B ST7920 LCD screens backlight - 25pcs supplied
Pre-flashed Cockles - 25pcs supplied

Solar USB chargers - 10pcs supplied (1 in testing) - 1pcs MISSING

3m USB White Male A to Male Micro B - 18pcs MISSING
3m USB Male A to Female A USB - 10pcs MISSING

2x4 Dupont Insulators - 15pcs supplied - 10pcs MISSING
1x6 Dupont Insulators - 16pcs supplied - 34pcs MISSING
2x1 Dupont Insulators - 25pcs supplied
1x1 Dupont Insulators - 75pcs supplied
40conductor 100mm female uninsulated dupont rainbow cables - 15pcs supplied

Female A USB Mains adaptors - 18pcs supplied
Male Micro B Mains adaptors - 5pcs supplied

400pt Breadboards - 25pcs supplied

pre-stripped prototyping wires - 75ish supplied in 3 colors
male 15mm headers - 15 pcs supplied
female right angle headers - 15 pcs supplied

414g of Blue RFID tags with keyrings 20pcs=87g

# 9th May

Bag 1pin dupont insulators
4x20pin 200mm Male->Female Dupont Ribbon cable
USB Male A to Micro B 3m [expensive] 3pcs
USB Reversible Male A to Micro B 5m 1pcs
USB Reversible Male A to Micro B 3m 1pcs
USB Male A to Female A USB extender Cream 5pcs

Closed 2017-07-03.

Thread 63 (2017-04-20):

Draw a horse for the boxes

cheapjack, 2017-04-20:

cefn, 2017-04-21:
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

cheapjack, 2017-04-22:
Actually im not convinced a horse is right now. And its not to do with Trump! It makes sense in the game world but I *think* generally kids of the welded to the tablet generation are pretty aware of a wifi/wireless logo...

cefn, 2017-04-22:
If I recall, we weren't trying to find an image to represent the interaction, and in fact that was the key takeaway from this part of the meeting.

The issue was rather what can we INSTRUCT people to do. Horse is good for this, but the main conclusion we had drawn was 'anything but the wifi/tag logo' since it was near-impossible to instruct without a paragraph of description, as hinted by your use of 'wifi/wireless logo'. What is that vector art called? We don't want to be saying RFID and it means little anyway. Perhaps you have a solution for this which means we _can_ use the RFID/WIFI logo but somehow solve the original issue of instructing? Horse has absolutely no problem here.

We are not expecting anyone to know what to do without following the instructions and the semantics are entirely unlike Wifi. The only possible advantage of some already-laden symbol is if you were to hand someone the tag and say 'go play the game' with no instructions, seems an unlikely scenario.

gkboulter, 2017-04-24:
Tried and struggled to make a horse image on Friday that was in keeping with the aesthetic...

Could we go with something really simple and universal like a circle / square / compass points?

cheapjack, 2017-04-24:
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

Yes that was the logic we ended up with anything but a rfid contactless sign i guess..I'd lost the rationale for it: ive also tried to make a lo-bit horse so its in keeping but not happy withit:
compass is a great idea though and as 'tapping' is how you 'travel' through the game it kind of makes sense... @gkboulter can you knock up a compass in keeping? Remember must be cut from single piece of acrylic..

cheapjack, 2017-04-24:
Felix suggested putting the stickers on the tap point. I think would rather it a physical part of the box rather than a sticker which feels a bit cheap... you do have to press the tag flat to the horse to get a read so will have to add that to the text instruction..

Closed 2017-05-03.

Thread 65 (2017-04-20):

Establish Looms for assembly

cheapjack, 2017-04-20:
## Reader
2 block
4 block and weave
1 single, 3V
7 total conductors

## Screen
2 singles
2 power(5V) and ground jumpers
2 x 4 block (got 15)
10 totale conductors

## Power
2 power jumpers for 5V

500 conductors in total

cheapjack, 2017-04-22:
I've somehow mixed this all up and cocked up a few, but have managed to wire up 3 boxes power them up and get screens and readers working though obviously without out build on board yet.

What we actually need is
## Reader
1 1x2 block
2 1x6 block (one side weave and includes using the 3V3 & GND lines between `D5` & `D4`)
1 single, 3V (to share cockle pin `D5` with the screen)
7 total conductors (1 unused)

## Screen
### Screen-side
1 1x2 blocks(Double)
2 singles
1 1 x 6 block
### breadboard side
2 power(5V) and ground jumpers
2 x 4 block (got 15)
1 single for `RS` to connect to 5V?
10 totale conductors

## Power
2 power jumpers for 5V
1 jumper to share cockle pin `D5`

500 conductors in total

Closed 2017-05-05.

Thread 66 (2017-04-20):

Confirm all components for assembly

cheapjack, 2017-04-20:
# ComponentList :scroll:

|Item|Got them
|----|----
|RFID tags [with this reader](http://www.electrodragon.com/product/mifare-rc522-rfid-card-readerdetector-ic-card/) **YES**|<ul><li>[x] </li>
|MileCastle round Cavalryman Sticker|<ul><li>[x] </li>

# Boxes Minimum
**17 internals**
**5 externals**
**1 internal with battery**

# Colours for interior
Senhouse 3 white
Tullie 3 white 1 black
Corbridge 3 white
Housesteads 1 white

25 screens in white
25 cockles

## Internals for interior Boxes
|Item|Got them
|----|----
|Headers & dupont connectors|<ul><li>[ ] </li>
|400 point breadboard|<ul><li>[ ] </li>
|Micropython Cockle|<ul><li>[ ] </li>
|90 degree headers for screens|<ul><li>[ ] </li>
|90 degree headers for readers|<ul><li>[ ] </li>
|2 and 4 Dupont Connector Blocks for readers
|1 single male to female for readers
|2 x 4 Dupont Block for Screens|
|2 single male to female for Screens
|2 power jumpers to make a 5V rail for Screens
All 15mm gauge
|[RFID-RC522](http://www.electrodragon.com/product/mifare-rc522-rfid-card-readerdetector-ic-card/) Read/Writers|<ul><li>[x] </li>
|128x64 White Backlit LCD pixel screens|<ul><li>[ ] </li>
|[Panel mount internal micro-USB-B extension](https://www.aliexpress.com/item/1PCS-lot-150CM-OBD-II-OBD2-16-Pin-Male-to-Female-Diagnostic-Extension-Cable/1482186322.html) from micropython cockle port|<ul><li>[x] </li>
|Female USB-A Mains Plug|<ul><li>[x] </li>
|White Male USB-A to Male micro USB-B Extension 3M|<ul><li>[x] </li>
|Female to Male USB-A extenders|<ul><li>[ ] </li>

## Internals for 5 Off-grid Boxes
|Item|Got them
|----|----
|IP66/8 grommet|<ul><li>[x] </li>
|reed switch & magnet|<ul><li>[ ] </li>
|[IP66/68 Rated Waterproof Boxes](https://www.aliexpress.com/item/Low-shipping-cost-high-quality-ip66-plastic-enclosure-box-with-transparent-lid-140-170-95mm/1708264367.html)|<ul><li>[x] </li>
|Headers & dupont connectors|<ul><li>[ ] </li>|<ul><li>[x] </li>
|90 degree headers for screens|<ul><li>[ ] </li>
|90 degree headers for readers|<ul><li>[ ] </li>
|400 point breadboard|<ul><li>[ ] </li>
|Micropython Cockle|<ul><li>[ ] </li>
|[RFID-RC522](http://www.electrodragon.com/product/mifare-rc522-rfid-card-readerdetector-ic-card/) Read/Writers|<ul><li>[x] </li>
|128x64 White Backlit LCD pixel screens|<ul><li>[x] </li>
|Micro B Male to |<ul><li>[x] </li>

## Externals for Off-grid Boxes
|Item|Got them
|----|----
|Internal & External Fixings for side/rear fixing to fence posts/signs|<ul><li>[ ] </li>
|Battery Pack bracket on reverse: additional through hole fixings|<ul><li>[x] </li>
|Box acrylic bent wings for lid socket|<ul><li>[ ] </li>
|Adjust skin for lid|<ul><li>[ ] </li>
|Tinted acrylic Lid with inset magnet|<ul><li>[ ] </li>
|USB Charger port/cable & reed switch lines [grommet plug shell cap cover](https://www.aliexpress.com/item/6-Pieces-Waterproof-Aviation-Connector-Plug-Shell-Cap-Cover-for-GX16/2053433214.html) |<ul><li>[x] </li>
|MicroUSB-B (cockle) extension to exiting USB-A via IP66/8 grommet|<ul><li>[ ] </li>
|Exiting USB-A to an external solar battery pack|<ul><li>[ ] </li>
|[USB Solar battery Pack](http://www.ebay.co.uk/itm/Waterproof-12000mAh-Solar-Battery-Quick-Charger-Power-Bank-Pack-For-Mobile-Phone/262902644680)|<ul><li>[x] </li>

## Externals for on-grid & off-grid boxes
|Item|Got them
|----|----
|Decorative acrylic for Outer Case Designs|<ul><li>[x] </li>
|Internal acrylic material|<ul><li>[x] </li>
|M6 10mm for lid socket|<ul><li>[ ] </li>
|M6 70mm [Coach bolts](http://www.ebay.co.uk/itm/191920495458)|<ul><li>[x] </li>
|M6 100mm [Coach bolts](http://www.ebay.co.uk/itm/191920495458) for off-grid boxes|<ul><li>[x] </li>
|M6 120mm [Coach bolts](http://www.ebay.co.uk/itm/191920495458) for off-grid boxes|<ul><li>[ ] </li>
|M6 nuts|<ul><li>[x] </li>
|M6 nut covers|<ul><li>[x] </li>
|M6 washers|<ul><li>[ ] </li>

Thread 67 (2017-04-21):

Make a reference wiring diagram

cheapjack, 2017-04-21:
@cefn ive got completely lost in my wiring photograph reference Im going to need a solid reference diagram!

cheapjack, 2017-04-21:
Ah can I just use this in the [st7920 repo](https://github.com/ShrimpingIt/micropython-st7920/blob/master/st7920.py)?

```
EXAMPLE WIRING (MCU runs at 3.3V, so use VIN to get 5V)
        * RW    - GPIO13 (Cockle pin7)  - SPI MOSI
        * E     - GPIO14 (Cockle pin5)  - SPI Clock
        * PSB   - GND                   - Activate SPI
        * RST   - 5V                    - resetDisplay
        * V0    - 5V                    - LCD contrast
        * BLA   - 5V                    - Backlight Anode
        * BLK   - GND                   - Backlight Cathode
        * VCC   - 5V                    - USB power VIN (not 3V3)
        * GND   - 0V

    By default, attempts to wire to Hardware SPI as described at https://docs.micropython.org/en/latest/esp8266/esp8266/quickref.html#hardware-spi-bus
```

cheapjack, 2017-04-22:
@cefn managed to wire up everything with no pot for contrast following this and what we'd previously done for the reader but unsure what to do with `RS` on the screen which I think is a chip select thing so do we ignore it/not connect or power it on 5V?

Should we include the pot just in case they need adjusting? Theres a handy 3mm hole we could fix a screwhead pot like the one @cefn had on his reference circuit then a small cross-head screwdriver could adjust so the public wouldnt try to...

cefn, 2017-04-22:
My RS is wired direct to 5V, but unsure if the Chip Select/Slave Select thing has been figured out for sure on screens. Haven't done a lot of RFID+Screen shenanigans to prove all is sane switching between them. Possibly screen select isn't currently in use as in my circuit RS is wired direct to 5V. Been using https://github.com/olikraus/u8g2/wiki/setup_tutorial for hardware wiring reference information.

cefn, 2017-04-22:
As for Potentiometer, there is [a scenario](http://www.pacificdisplay.com/lcd_cont_adj.htm) in which the deployment temperature is different from the testing temperature which might require variation in the contrast setting. If it doesn't require deployment of a circuit board, then could include it, so long as it doesn't create extra potential for failure compared to direct wiring.

cefn, 2017-04-23:
Seemed this issue of needing reference wiring was resolved by your experiments, but want to be sure. Did you successfully write data to the screen, then? However, I feel a reference diagram is worth doing anyway in the long run.

I have allocated D8 (as per cockle naming - actually ESP GPIO pin 15) for wiring of the Screen RS pin (seems to be active high). Means R/W and RS are neighbours on the cockle, for allocating future insulators.

That should address any issue from crosstalk between the SPI of screen vs. reader in the long run, though weirdly it wasn't an issue in integration testing, despite RS apparently being active the whole time. Whatever is sent to the card must be ignored by the screen for some reason, but I guess we can't rely on this, so using Chip Select makes sense. I think it is now in use in my testing rig.

I'm guessing we'll only know if your wiring is solid after you can run the integration test main.py.

Currently my integration test (for integration-testing hardware) is at https://github.com/cefn/avatap/blob/master/python/integration_main.py

The cockle filesystem currently looks as follows to service the integration test...

```
$ ampy --port /dev/ttyUSB0 ls
bitfont.py
st7920.py
mfrc522.py
faces
main.py

$ ampy --port /dev/ttyUSB0 ls faces
font_5x7.py
```

You can populate the dependencies like...
```
$ ampy --port /dev/ttyUSB0 put micropython-st7920/st7920.py
$ ampy --port /dev/ttyUSB0 put micropython-mfrc522/mfrc522.py
$ ampy --port /dev/ttyUSB0 put bitfont/bitfont.py
$ ampy --port /dev/ttyUSB0 mkdir faces
$ ampy --port /dev/ttyUSB0 put bitfont/faces/font_5x7.py faces/font_5x7.py
$ ampy --port /dev/ttyUSB0 put avatap/python/integration_main.py main.py
```

cheapjack, 2017-04-24:
```
Screen
Left to Right when screen flipped and in install position with gamebox upright
        * BLK   - GND                   - Backlight Cathode
        * BLA   - 5V                    - Backlight Anode
        * RST   - 5V                    - resetDisplay
        * PSB   - GND                   - Activate SPI
        * E     - GPIO14 (Cockle pin D5)  - SPI Clock
        * RW    - GPIO13 (Cockle pin D7)  - SPI MOSI
        * RS    - GPIO15 (Cockle pin D8)  - Chip select ?
        * V0    - 5V                    - LCD contrast
        * VCC   - 5V                    - USB power VIN (not 3V3)
        * GND   - 0V                   - Ground
RFID Reader
        * SDA        Cockle Pin D5 GPIO14 (shared with SPI Screen)
        * SCK        Cockle Pin D3  GPIO0
        * MOSI      Cockle Pin D4  GPIO2
        * MISO      Cockle Pin D2 GPIO4
        * GND      Ground
        * RST       Cockle Pin D1 GPIO5
        * 3V3        3V3
```
@cefn Just tried all that with wiring as above not much happening: I removed the boot.py that was there was that wrong? Screen on but no read...just tried to make filesystem the same as yours

cheapjack, 2017-04-24:
actually im getting this over serial when i read a tag
```
Address send allocated: -64
Data send allocated: -32
```
which means rfid or something working?

cheapjack, 2017-04-24:
oh looks like writing to the screen actually...

cheapjack, 2017-04-24:
ive added an issue with more detail in an [avatap issue](https://github.com/cefn/avatap/issues/4)

cheapjack, 2017-04-25:
Leaving this open until we have a nice KiCad diagram
I've made more detail and some reference images so far in [AssemblyWiring.md](https://github.com/cheapjack/MileCastles/blob/master/boxes/AssemblyWiring.md)

```
Screen
Left to Right when screen flipped and in install position with gamebox upright
        * BLK   - GND                   - Backlight Cathode
        * BLA   - 5V                    - Backlight Anode
        * RST   - 5V                    - resetDisplay
        * PSB   - GND                   - Activate SPI
        * E     - GPIO14 (Cockle pin D5)  - SPI Clock
        * RW    - GPIO13 (Cockle pin D7)  - SPI MOSI
        * RS    - GPIO15 (Cockle pin D8)  - Chip select ?
        * V0    - 5V                    - LCD contrast
        * VCC   - 5V                    - USB power VIN (not 3V3)
        * GND   - 0V                   - Ground
RFID Reader
        * SDA        Cockle Pin D5 GPIO14 (shared with SPI Screen)
        * SCK        Cockle Pin D3  GPIO0
        * MOSI      Cockle Pin D4  GPIO2
        * MISO      Cockle Pin D2 GPIO4
        * GND      Ground
        * RST       Cockle Pin D1 GPIO5
        * 3V3        3V3
```

cheapjack, 2017-04-28:
Latest to include Pololu
```
Screen
Left to Right when screen flipped and in install position with gamebox upright
        * BLK   - GND                   - Backlight Cathode
        * BLA   - 5V                    - Backlight Anode
        * RST   - 5V                    - resetDisplay
        * PSB   - GND                   - Activate SPI
        * E     - GPIO14 (Cockle pin D5)  - SPI Clock
        * RW    - GPIO13 (Cockle pin D7)  - SPI MOSI
        * RS    - GPIO15 (Cockle pin D8)  - Chip select ?
        * V0    - 5V                    - LCD contrast
        * VCC   - 5V                    - USB power VIN (not 3V3)
        * GND   - 0V                   - Ground
RFID Reader
        * SDA        Cockle Pin D5 GPIO14 (shared with SPI Screen)
        * SCK        Cockle Pin D3  GPIO0
        * MOSI      Cockle Pin D4  GPIO2
        * MISO      Cockle Pin D2 GPIO4
        * GND      Ground
        * RST       Cockle Pin D1 GPIO5
        * 3V3        3V3

Soft latch, hacked USB-A to USB-B 9 (micro) male crimped all male, 2 female crimped DATA1 & DATA2 on USB-B (micro)
        * GND IN  GND from Male USB-A
        * VIN   VIN from Male USB-A
        * OFF   Cockle Pin D6
        * 10K across OFF & Cockle Pin D6
        * GNDOUT   GND to Male USB-B (micro)
        * VOUT  VOUT to Male USB-B (micro)
        * DATA1   DATA1  over male female crimp

VIN Power Rail
PIN1  Pololu ON?
PIN2

```

cefn, 2017-04-28:
Worth listing DATA2?

Also did you move the 10k or did you find that it worked in series in the place of a wire (this is certainly feasible. Previously it was wired as a pull-down between OFF and GND - or should have been). Sadly I didn't take a pic of the working configuration for reference.

cheapjack, 2017-05-18:
Been working with this now until further notice more details in #86
# Loom to Cockle wiring details

## Screen Loom 1

BLK -> 0V [Brown] - Backlight Cathode
BLA -> 5V [Red] - Backlight Anode
VOUT -> UNCONNECTED [Black] - Reference voltage
RST -> 5V [White] - Screen Reset
NC -> UNCONNECTED [Grey] -  Not Connected (unused pin)
PSB -> 0V [Purple] - Parallel Serial Bus selector (indicating we are using Serial - SPI)

## Screen Loom 2

E-> D5/GPIO14 [Blue] - SPI SCK (Serial Clock)
R/W -> D7/GPIO13 [Green] - SPI MOSI
RS -> D8/GPIO15 [Yellow] - Screen SPI Slave Select
V0 -> 5V [Orange] - LCD Contrast voltage
VCC -> 5V [Red] - Power supply +5V positive
GND -> GND [Brown] - Power supply common negative

## Reader Loom

SDA -> D4/GPIO2 (Black) - Reader SPI Slave Select
SCK -> D5/GPIO14 (White) - SPI Serial Clock
MOSI -> D7/GPIO13 (Grey) - SPI MOSI
MISO -> D6/GPIO12 (Purple) - SPI MISO
IRQ -> UNCONNECTED (Blue) - Interrupt Request Pin (as yet unused)
GND -> GND (Green) - Power supply common negative
RST -> D3/GPIO0 (Yellow) - Reader Reset
3.3V -> 3.3V (Orange) - Low Power supply +3.3V positive

## Pololu power trip

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

Closed 2017-06-01.

Thread 68 (2017-04-22):

Make a website frontpage pointing to milecastles.uk

cheapjack, 2017-04-22:
Include
Video in-use
All material in the additional print

gkboulter, 2017-06-30:
Soldier graphics for website are in this folder:
https://drive.google.com/open?id=0B5imPjsSmpRkTEw5dU81Nk1id3c
Google form for prize draw is here:
https://goo.gl/forms/bqOiZGwvtmmz0e493
Jupiter font in there also
Will replace map jpgs once we finalise next (final) run.

cheapjack, 2017-06-30:
Initial barebones [homepage for milecastles.uk url](http://milecastles.uk) done. Will improve, add instructional artwork and proper fonts, logos, tips, blog posts etc over wknd

Will leave this open until we happy with it and we've made logos and colours better

thanks @gkboulter !

gkboulter, 2017-06-30:
Looks really good Ross - great that it's up in time Tina Turma weekend. I wouldn't rush to add anything else to it before next week now the front page and survey link are up.

cheapjack, 2017-06-30:
👍 Also updated the Domestic Science homepage just in case `Tiny Turma` commissions us for a 10 million quid text adventure based on `Mad Max Beyond the Tinderdome`

Closed 2017-07-09.

Thread 77 (2017-04-27):

Make risk assessments for all the installs

cheapjack, 2017-04-27:

gkboulter, 2017-05-02:
A general risk sheet to cover all sites (indoor and outdoors) here:
[MILECASTLES RISK ASSESSMENT](https://docs.google.com/spreadsheets/d/1_q5nkvIG3mbnqPf6uHtJrUBNY0iSWJ-8bwP5XmgRg4M/edit#gid=746338726)

Will need to add following items to print:
- Choke hazard warning for game tags
- 'Do not run' advice to avoid tripping etc, particularly in outdoor sites

Edits from @cefn and @cheapjack welcome.

Closed 2017-06-01.

Thread 79 (2017-05-03):

Send Ross 4 reed switches and magnets

cheapjack, 2017-05-03:
Sorry forgot to pick up this last week can you next day it to DoES for tomorrow Thursday 4th may? http://doesliverpool.com/location

Still in Wales will try catch up later this afternoon if I can :)

cefn, 2017-05-03:
Hi there. I don't have a supply of the magnets. The one I found was a magnet lying around - was on my fridge.  I have now dispatched the other three I had on my fridge, (which I think are identical) but that leaves you one short.

cheapjack, 2017-05-03:
Ok have an alternative for that one I think but not as low profile :) ring you soon for update when I can:)

Closed 2017-05-03.

Thread 80 (2017-05-03):

Investigate Series Resistor on screens

cefn, 2017-05-03:
Need to check what series resistor if any is inlined between power and backlight, which might differ between screen models (Green vs White) as they have different backlight arrangements. Over-driving the voltage of the backlight without a series resistor in place would shorten its effective life. This can be tested with a multimeter.

Thread 85 (2017-05-03):

Staff box running instructions and troubleshooting guide

cheapjack, 2017-05-03:
- Outdoor box is attached with an external solar battery
- LIfting the box lid activates the box ready for play, closing the box sends it back to sleep
- External solar battery will need to be periodically swapped every 2 days/weekly with the identical battery stored in the office
- Carefully disconnect the battery after opening its waterproof bag
- Connect with fresh battery and reseal the bag
- Use only the supplied power supply, to recharge batteries, it has a raspberry logo and a Milecastles sticker on it

cheapjack, 2017-06-23:
@gkboulter we need this for Monday 26th June for Frances to review

gkboulter, 2017-06-23:
@cheapjack will do this today/Monday and send to Frances for Monday noon. Will make a general version that can be adapted for sites with mixture of indoor/outdoor boxes.

gkboulter, 2017-06-26:
Started doc here:
[Google doc](https://docs.google.com/document/d/1LmOioHl9tQV6nZiNMnaV2-PxuIDCnLINOb3pa8PIB9g/edit?usp=sharing)
@cheapjack - Just need advice on a couple of points before sending to Frances.
Can print some copies also and attach map for reference.

cheapjack, 2017-06-26:
Ive updated it, resolved comments and sent as pdf to you, Lisa & Frances ta 👍

gkboulter, 2017-06-26:
Thanks Ross - am in Barrow tomorrow so can print a few copies ready for Weds.

cheapjack, 2017-06-27:
Made a final update to pdf after revised outdoor box behaviour emailed to Corbridge and cc'd @gkboulter 👍 Need to do a similar one for Tullie but without the outdoor box bits if you can do that?

Closed 2017-07-03.

Thread 86 (2017-05-03):

Provide integration test image and wiring reference

cefn, 2017-05-03:
This is an issue as per telecon with @cheapjack  to provide an integration testing image as well as wiring reference information for the use of Hardware SPI.

This should be uploaded using esptool.py

The (fastest) invocation I use which relies on the use of the esptool.py v2 flasher stub (insanely fast) is...

```esptool.py --port /dev/ttyUSB0 --baud 1500000 write_flash --flash_mode dio --flash_size=32m 0 integration-test.bin```

However, the standard esptool.py v1.3 is the one installed by _pip2_ and _pip3_ and probably needs to be invoked with a lower baud rate...

```esptool.py --port /dev/ttyUSB0 --baud 115200 write_flash --flash_mode dio --flash_size=32m 0 integration-test.bin```

On success, it should make positive noises. You should then unplug and replug the cockle and it should report "Hello World" on screen. Placing an RFID on it should cause the tag id to be displayed.

If you want to be sure the firmware is operating, but not sure of your wiring, try connecting like...
```screen /dev/ttyUSB0 115200```

Initially this will show nothing and be unresponsive, since it should be running the test case. Hit CTRL+C to kill the running test case, and you should have the normal REPL chevrons, and be able to run...

```
test.run()
```

...to begin the test routine again (causing "Hello World" on screen and looking for tags)

cefn, 2017-05-03:
The initial version of the firmware image, tested locally with my wiring is now available at https://github.com/cefn/avatap/blob/master/firmware/integration-test.bin

cefn, 2017-05-03:
Wiring is as per the Hardware SPI pin assignments at https://docs.micropython.org/en/latest/esp8266/esp8266/quickref.html#hardware-spi-bus

I have assigned colors based on 20 pins - half a 40 pin rainbow dupont split exactly down the middle.

_NOTE!_ The cockle is placed in a breadboard with an offset, to allow two pins next to the D1-D8 pins. This means two wires need to be inserted into the 5v and GND rows to break out the rows to the power rails on the other side beneath the cockle BEFORE inserting it in the breadboard. I used a pair of tinned copper (@ShrimpingIt) jumper wires pre-bent to come out from under the board at the top, bent back and connected to the power rails.

The looms have the following sequence, in two groups of 6 for the screen and one group of 8 for the reader. They are listed below in the sequence left to right based on the boards facing upwards flat on the desk, with pins pointing toward you. note the 10 colors are each used twice...

## Screen Loom 1

Brown, Red, Black, White, Grey, Purple

Far left 6 pins

## Screen Loom 2
Blue, Green, Yellow, Orange, [Red, Brown TWISTED] !! Keeps Red +5v, Brown GND

Far right 6 pins

## Reader Loom

Black, White, Purple, Blue, Green, Yellow, Orange

All 8 pins

# Loom to Cockle wiring details

## Screen Loom 1

BLK -> 0V [Brown] - Backlight Cathode
BLA -> 5V [Red] - Backlight Anode
VOUT -> UNCONNECTED [Black] - Reference voltage
RST -> 5V [White] - Screen Reset
NC -> UNCONNECTED [Grey] -  Not Connected (unused pin)
PSB -> 0V [Purple] - Parallel Serial Bus selector (indicating we are using Serial - SPI)

## Screen Loom 2

E-> D5/GPIO14 [Blue] - SPI SCK (Serial Clock)
R/W -> D7/GPIO13 [Green] - SPI MOSI
RS -> D8/GPIO15 [Yellow] - Screen SPI Slave Select
V0 -> 5V [Orange] - LCD Contrast voltage
VCC -> 5V [Red] - Power supply +5V positive
GND -> GND [Brown] - Power supply common negative

## Reader Loom

SDA -> D4/GPIO2 (Black) - Reader SPI Slave Select
SCK -> D5/GPIO14 (White) - SPI Serial Clock
MOSI -> D7/GPIO13 (Grey) - SPI MOSI
MISO -> D6/GPIO12 (Purple) - SPI MISO
IRQ -> UNCONNECTED (Blue) - Interrupt Request Pin (as yet unused)
GND -> GND (Green) - Power supply common negative
RST -> D3/GPIO0 (Yellow) - Reader Reset
3.3V -> 3.3V (Orange) - Low Power supply +3.3V positive

cheapjack, 2017-05-04:
@cefn Integration test is working so if you can get a Corbridge game image together tonight I think its worth us going up and scoping out the install and get some documentation. Magnet mechanism a little bit dodgy but im working on that.

cefn, 2017-05-04:
Shall I just designate a pin as the Polulu OFF pin? Should we say D1 (at a guess) since D0 seems to be special around powerup.

cheapjack, 2017-05-04:
👍 yes D1 should do

cheapjack, 2017-05-17:
@cefn Ive actually been wiring D2 to OFF on the pololu now sorry

cefn, 2017-06-14:
Now superceded by https://github.com/cheapjack/MileCastles/issues/107

Closed 2017-06-14.

Thread 87 (2017-05-04):

Provide Scale-Test Images for Prototype Corbridge Boxes

cefn, 2017-05-04:
There are four largely untested images for the four corbridge boxes at...
https://github.com/cefn/avatap/tree/master/firmware

These are identical to the box1 tester image I showed in the demo video, but with a different hard-coded 'box identity' configured on boot for each case.

Blank tags are expected to be overwritten with Corbridge-specific story storyUid, nodeUid and sack data if no previous data is found on them. However, once written, they should be recognised as part-played Corbridge tags. Be careful with them, therefore. If we change the logic, we might end up with half-played tags which create inconsistencies or break running boxes in the future. For now, let's try not to mix them with future customer tags.

Currently the repo hasn't been updated with all the source changes needed to build the images, but at least the images are there.

cefn, 2017-05-04:
BTW I have no idea if this is the latest corbridge. It's based on https://github.com/cefn/avatap/commits/125f1c3a52aa9180b3fc9d227e117498ac701c31/python/stories/corbridge.py

cheapjack, 2017-05-06:
Got images on boxes i - iii some glitches and  seemingly slow reads of tags but Need to review wiring thoroughly and list all observations. It would make sense if @cefn came over to DoES on Monday or Tuesday and troubleshoot with the actual boxes wired up and in use and maybe with Julian if he's around I'll email him; I'm working on something else Monday with Adrian but you could work in the workshop... Then I'm working on boxes Tuesday and Wednesday when I'll have to try build and wire up more boxes (a further 5 indoor and 3 outdoor) while we try resolve glitches in time fort next install on Thursday. It's awesome to see the game almost there though! it feels really nice! But we do need some kind of feedback to a successful read I think aside from displaying the text the game wants...

cheapjack, 2017-06-23:
as we've made new images for corbridge & tullie and remaining glitches have been broken out into seperate issues I'm closing this

Closed 2017-06-23.

Thread 88 (2017-05-04):

Write Read Print Cycle

cefn, 2017-05-04:
Discussed with Ross the issues around timings for Sack Read, Sack Write and Print appearing

As a reference, this interactive session may be relevant...

```
>>> startSack
{'epona': False, 'mars': False, 'superhorse': False, 'eponapoints': 0, 'hours': 0, 'marspoints': 0}
>>> from time import ticks_ms
>>> def writeSpeed():
...     ms = ticks_ms()
...     vault.writeJson(startSack)
...     print(ticks_ms() - ms)
... def readSpeed():
...     ms = ticks_ms()
...     vault.readJson()
...     print(ticks_ms() - ms)
>>> writeSpeed()
1549
>>> readSpeed()
944
```

Closed 2017-06-27.

Thread 94 (2017-05-11):

Comment on any issues from the fuzzing

cheapjack, 2017-05-11:
Fuzzing emulator great! So good to see actual display, love it! will get it up on @gkboulter laptop in the morning

Some feedback:

- `To begin work go to Box II` 🔪  although it almost fits the final pixles of the I character are missing so look like the numerals are cut off. Fix could be `goto` as in `goto 10`
- `Place Tag Below` ⬛️  think it should be capitalised, in reverse, white on black, maybe centre justified or even same as `Reading tag...` but capitalised
- `but you don't have long to`🔪 final pixel on the right lost in the `o` character, feels like its cut off
- `Reading tag...` 👍 in reverse white on black right justified is bang on, really like it. Wonder if `Place Tag Below` should be the same for consistency?

cefn, 2017-05-11:
The reason for Place Tag Below being big, is that it's expected to be read as you walk up to it. The remainder are expected to be read as you are directly looking at the screen.

Closed 2017-05-30.

Thread 96 (2017-05-18):

Confirm all instructional text

cheapjack, 2017-05-18:
Agree we need this to be bigger, just want to tweak font, capitalise message and justify centre if not too hard..
Be nice if it varied somehow having played with the `host.laptop` but think thats a non-essential enhancement at the moment

```
PLACE TAG
 TO PLAY
```
or maybe if smaller font (but still big)
```
 PLACE TAG
TO CONTINUE
```
like the direction of below but then the print kinda covers that.

cheapjack, 2017-05-19:
# Working out our instructional text...
### Keep tag placed while reading or you will miss it
`WAIT`

### Make sure we read the tag and write to it
`LOADING
 GAME TAG`

### Hold tag until writing is finished
`SAVING GAME...`

### Remove When ready
` READY TO
REMOVE`
### Replace for the next page

Taking
Remove and replace to get the next page

cheapjack, 2017-05-23:
` HOLD TAG
   BELOW`
alternating with
`XXXXXXXXX

MILECASTLES

XXXXXXXXXX`

`Loading Game...`
instead of
`Reading Tag...`

`Saving Game...`
instead of
`Writing Tag`

Once card read & written (loaded & saved) render text delay text by 3 secs?
#### "Now that its loaded and saved you can remove your tag if you've finished reading, and then hold tag below again to get the next page in the game"
`Read Remove and Replace for more`
`Ready to Remove Tag`

#### If we dont save the game to the tag (partial write)
` HOLD TAG
   BELOW`
again

cheapjack, 2017-05-30:
## Final instructions and default behaviours
Based on recent discussions with @cefn and @gkboulter this is where we are at

Default behaviour: dont worry about asci art but we just need something like an arcade 'standy screen' where `HOLD TAG BELOW` is a bit like `INSERT COIN`
So Maybe we get an arcade flashing text of:
```
XXXXXXX
   MILE
CASTLES
XXXXXXX

```
```
XXXXXXX

XXXXXXX

```
Maybe 2 'flashes' alternating with Capitalised, centre justified `font_ncenB14` (will need a new line to prevent chopping off the top) This smaller font is so there is some spacing around the text which just looks nicer in terms of typography (acknowledge the trade off to distance of ledgibility)
```

HOLD TAG
   BELOW

```
or
```

HOLD TAG
FOR PAGE

```

On presenting card,
```

                       Loading Game...
```
then

```
Welcome to Milecastles!
Look for numbered boxes
and hold your tag to
progress the story...

                       Saving Game...
```

Once card read & written (loaded & saved)

```
Welcome to Milecastles!
Look for numbered boxes
and hold your tag to
progress the story...

       Lift & hold for new page...
```

`absenceDelay = 0`: @cefn warned against this as people may get used to the delay rather than train themselves to just keep the tag on the reader

Then revert to Default behaviour:
```

HOLD TAG
FOR PAGE

```
followed by 2 flashes of
```
XXXXXXX
   MILE
CASTLES
XXXXXXX

```
```
XXXXXXX

XXXXXXX

```

What do we think of that? Im around later to chat 2ish?

cefn, 2017-06-01:
# Synonyms we considered...
* Present
* Place
* Put
* Position
* Touch
* Dock
* Slot
* Insert

Hold sounds like it could mean the opposite. Press suggests you might have to apply force, which we want to avoid for mechanical reasons. I think we've nailed it by trashing the word 'hold' and going with Place/Replace.

I think we settled on

    PLACE TAG
    TO READ

...as the general message, alternating with an occasionally flashing

    MILE
    CASTLES

I really like emphasising Milecastles ambiently, assuming that people can contextualise this phrase, which is otherwise mystifying (e.g. point-of-sale and leaflets have 'Milecastles' prominently).

The read write page sequence looks like...
1) PLACE TAG TO READ (BIG) [tag expected to be presented by player]
2) Loading game...[ tag kept in place]
3) Saving game... [ tag kept in place]
4) Lift & replace for more [ONLY IF PAGES REMAIN, ELSE NO LABEL] [tag kept in place until finished reading]
5) Place tag to read (SMALL) [ONLY IF PAGES REMAIN, ELSE LOOP TO 1)]

cheapjack, 2017-06-01:
## Final instructions and default behaviours
Updated @gkboulter based on last discussions with @cefn today

Default behaviour:

```

 MILE
CASTLES

```
Flash
```

```
```

 MILE
CASTLES

```
Then Capitalised, centre justified `font_timB14` (will need to prevent chopping off the top)
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

```

PLACE TAG
 TO READ

```

On presenting card,
```

         Loading Game...
```
then start with slightly more instructional intro text.

```
Welcome to Milecastles!
Look for numbered boxes!
Place your tag on the
tag symbol below & wait,
then lift & remove
to progress the story...

          Saving Game...
```

Once card read & written (loaded & saved)

```
Welcome to Milecastles!
Look for numbered boxes!
Place your tag on the
tag symbol below & wait,
then lift & remove
to progress the story...

Lift & replace for more
```

```
Welcome to Milecastles!
Look for numbered boxes!
Place your tag on the
tag symbol below & wait,
then lift & remove
to progress the story...

       Place tag to read
```

`absenceDelay = 0`: @cefn warned against this as people may get used to the delay rather than train themselves to just keep the tag on the reader

Then revert to Default behaviour:

```

PLACE TAG
 TO READ

```
followed by
```

 MILE
CASTLES

```
```

```
```

 MILE
CASTLES

```

I think that's it!

cheapjack, 2017-06-01:
Just re-confirmed behaviour more visually for @gkboulter & re-opened so he can see, will let @cefn have pleasure of re-closing :)

cefn, 2017-06-02:
Actually we've gone one better. Had a chat with @gkboulter and we now have...

* Keep in place, loading
* Keep in place, saving
* Lift & replace for more
* Place tag to read

Closed 2017-06-02.

Thread 98 (2017-05-23):

Complete the games with 24 char limit and add ... to ThroughSequences

cheapjack, 2017-05-23:
## @gkboulter

- [x] Arbeia
- [x] Housesteads
- [ ] Segedunum
- [x] Tullie House

## @cheapjack

- [x] Corbridge
- [x] Senhouse

gkboulter, 2017-05-24:
@cheapjack - just pushed Housesteads with character limit fixed and game paths tested in new emulator. Arbeia to follow tomorrow am.

gkboulter, 2017-05-25:
@cheapjack pushed updated **Arbeia** with character limit fixed and tested all paths/endings in new emulator. Working on Tullie next.

cheapjack, 2017-05-25:
@gkboulter great ive pulled them to mine. Hit a weird loop in Corbridge where cant seem to get to the pub! Trying to resolve it

gkboulter, 2017-05-26:
Nearly there with Tullie House - need another half day or so to test properly and reduce the text as it's too at the minute in terms of reading/tapping.

gkboulter, 2017-05-31:
Sorry, **Tullie** taking a bit longer than expected and slowed down by couple of problems testing on emulators (not always building all templates), back on it tomorrow a.m. and will push then.

cheapjack, 2017-06-01:
Don't worry Glenn @cefn tied up until this afternoon anyway. I'll plod on with boxes

cheapjack, 2017-06-01:
Make sure we add the more explicit Intro text to the first `landing` ThroughPage:
```
Welcome to Milecastles!
Look for numbered boxes!
Place your tag on the
tag symbol below & wait,
then lift & remove
to progress the story...

```

cefn, 2017-06-04:
I think we need to be as careful with this as the other instructional guidance we have offered, so let's put this text in one place and import it from there, where it can be maintained and improved. Named variables can be referred to just like any other value, so in stories/__init__.py we could declare...

introText="Blah blah"

...and in the actual story files...

page=stories.introText

In particular, "lift and remove" is a typo.

Also the guidance to 'place below...then lift' is misleading compared to the more closely considered wording we have elsewhere, which should prevent people from lifting until both the following are satisfied...
* game has been saved to the tag
* player has finished reading current page

cheapjack, 2017-06-05:
ok @gkboulter @cefn how about:
```
introText="""
Welcome to Milecastles!
Look for numbered boxes!
Place tag on the symbol
& keep in place to read
then lift & replace to
progress the story...
""",
```

and in most `landing` uid's we've got a ThroughSequence to start with so how should we get to it?
Easiest way seems to be that we make `startNodeUid=firstLanding` then `from stories import introText` and make this point to the `landing` first page; then we can remover the Welcome message from there?
```
ThroughPage(
uid="firstLanding",
goalBoxUid=entranceBox.uid,
nextNodeUid="landing",
page=introText,
)
```

cheapjack, 2017-06-05:
I cant get it to work that way as I dont seem to have a `stories.init.py` and didnt know how to mess with that so Ive just placed introText as a variable at the top

cefn, 2017-06-05:
Stupid Github markup hid the other characters. Should have read ```stories/__init__.py``` see https://github.com/cefn/avatap/blob/master/python/stories/__init__.py it's currently empty but can contain any needed python.

It's nice to have a single copy of this text (given it's embedded inside the actual stories, not part of the guidance system) to satisfy the requirements of DRY -
 from the Pragmatic Programmer. See https://en.wikipedia.org/wiki/Don%27t_repeat_yourself

cheapjack, 2017-06-05:
Yes no worries I've added it now, just not fully up on using `__init__.py` so now it has simply
```
introText="""
Welcome to Milecastles!
Look for numbered boxes!
Place tag on the symbol
& keep in place to read
then lift & replace to
progress the story...
"""
```
Ive added that in as suggested, also done so with TullieHouse.py and will do rest of @gkboulter games as i get them. So ive pushed `TullieHouse.py` and `corbridge.py` so we can build game images for those asap 👍

cheapjack, 2017-06-05:
I'll add the `introText` and `firstLanding` to Segedunum once I get from @gkboulter then we can close this and all games are ready for @cefn to build

I've done some further Tullie and arbeia testing, made some amends added some logic so that characters don't say True and False added the `introText` and `firstLanding` to both and fixed a weird bug in senhouse.

btw should we be using the agnostic module in everything for the cross platform issue? Only appears in Senhouse at present just so you know

cefn, 2017-06-05:
I'm expecting to go through using agnostic garbage collection in a paranoid way to minimise memory fragmentation, but don't worry, that's not your job :)

cheapjack, 2017-06-05:
👍

Closed 2017-07-09.

Thread 100 (2017-05-30):

Re-Cut the final 2 boxes

cheapjack, 2017-05-30:
Turns out in final session at Aaron's material was bizarrely 3.6mm and not 3mm which means it wont fit well :(
Now need:

- [ ] 2 more indoor bases
- [ ] 2 sides
- [ ] 2 engraved sides

cheapjack, 2017-05-30:
- [x] achievement unlocked, 100 issues

cheapjack, 2017-06-01:
Found a quicker workaround now Gerald in DoES is back up :)

Closed 2017-06-01.

Thread 102 (2017-06-05):

Update Lisa Keys on Progress

cheapjack, 2017-06-05:

cheapjack, 2017-06-05:
Be good to update her with proof of the revised print text @gkboulter 👍

gkboulter, 2017-06-05:
Latest proofs with revised text from Friday / Monday - can help with update tomorrow @cheapjack

As pdf (zipped):

[HC Map v11.pdf.zip](https://github.com/cheapjack/MileCastles/files/1052974/HC.Map.v11.pdf.zip)

As jpgs:

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

Closed 2017-06-07.

Thread 104 (2017-06-05):

Review the power-off cycle

cheapjack, 2017-06-05:
Currently using `D2` connected to `OFF` on the Pololu in the outdoor boxes so just need to go over the code for that. Should be included universally I guess but with indoor boxes ignoring it.

Bit mixed up over the resistor on the Pololu`OFF` to be `pull-up` or `pull-down`
Currently its configured with 10K to `Pull-Down` as that seemed to make sense as when the reed swtich is open (in proximity to magnet ie lid closed) it will be a 'normally low' signal ie no power and then when magnet is removed ie the lid opens, it will allow power to the Pololu which will signal high and the resistor pulls it back down cleanly afterwards...

Not sure if Ive mixed this up in my basic understanding of `pull-up` and `pull-down`

cefn, 2017-06-26:
For reference, I propose using D8 connected to OFF on the Polulu.

In the new wiring, D2 is used for one of the SPI wires to the screen, so that won't fly. The only free pins currently are D0/GPIO16 D3/GPIO0 and D8/GPIO15. GPIO16 and GPIO0 might both struggle with Polulu OFF role - GPIO0 has to be pulled up on boot to ensure entry into ```FLASH (NormalRunning)``` mode. I guess the circuitry in place for this would therefore send a high pulse to OFF the moment it powers up. GPIO16 has some behaviours about sending pulses as the Cockle moves out of deep sleep too, so best avoided for removal of doubt even though it's unlikely to be a problem. That leaves D8/GPIO15 which I'll try to prove tomorrow by integrating with the final image.

# References for my reasoning

You can see some of the special behaviours of Cockle pins according to their GPIO numbers [here](http://www.esp8266.com/wiki/doku.php?id=esp8266_gpio_pin_allocations). It reports that the voltage of D8/GPIO15 helps to determine the boot mode, requiring it to be pulled down in both modes we actually use - Upload and NormalRunning, so that's what I'll try.

And [this thread](http://www.esp8266.com/viewtopic.php?f=32&t=11614) offers some confirmation...
> Since GPIO15 (D8) is used by the boot mode process, most of the boards have this pin pulled down by an external resistor, which is stronger than internal weak pullup.

Finally the [NodeMCUv2 schematic](https://raw.githubusercontent.com/nodemcu/nodemcu-devkit/master/Documents/NODEMCU_DEVKIT_SCH.png) indicates D8/GPIO15 has the correct pull in place already hard-wired. After boot, we can set D8 it as a GPIO pin with an _active low_ voltage, then pulse it _active high_ to trigger power-off at our leisure.

# Your Circuit question

For reference, there are two entirely different circuits here and your comment seems to suggest they are coupled somehow.

1. One is a circuit wired across a pair of pins used to control POWER-ON behaviour. A button is normally expected to be wired across these pins, and a reed switch is equivalent to a button. In this sub-circuit there needs to be no wiring to the Cockle, and no wiring of a pull resistor.
2. Entirely separately, there is a wire from a digital pin (D8 proposed) to the POWER-OFF pin of the Polulu board which should be set in software to trigger POWER-OFF when needed.

The [documentation for the Polulu switch](https://www.pololu.com/product/2808) describes operation as...

> OFF	A high pulse (> 1 V) on this pin turns off the switch (e.g. allowing the target device to shut off its own power).

In case the pin attached to OFF was ever floating (e.g. during power up before it is told to be an output and set to a specific voltage) I originally had some concerns that it might trigger POWER-OFF just from random variations. Having selected D8, there is a resistor pull-down even when the microcontroller hasn't actively set the voltage, so fingers crossed this case should be handled automatically.

cefn, 2017-06-27:
Update, D8 is apparently set to value(1) == 3.3V on boot for some mysterious reason (a LED lights until you set it as an output pin in software, when it suddenly goes dark). I fear this means we can't use it.

cheapjack, 2017-06-27:
Thanks for all that @cefn hadn't seen it before we talked.

So we've decided to go with what you describe [above](https://github.com/cheapjack/MileCastles/issues/104#issuecomment-311205945)

"a circuit wired across a pair of pins used to control POWER-ON behaviour. A button is normally expected to be wired across these pins, and a reed switch is equivalent to a button. In this sub-circuit there needs to be no wiring to the Cockle, and no wiring of a pull resistor."

So I've gone with a 10k pull-down resistor between `CTRL` on Pololu and `GND` on Pololu and then the reed switch wired between `5V` & `CTRL` wired in it's normally closed config with the magnet contact keeping it open *ie* When lid is lifted the switch reverts to it's normally closed position and connects `CTRL` to 5V so pulses `HIGH` from  the `LOW` that the pull-down resistor is keeping low. At least that's how I understand it and it works!

So @gkboulter outdoor behaviour is hold lid up to power up and use, then close lid when you're done which seems pretty logical even if you need 2 hands. Dont think this clashes with the print description in any way 👍

Ill leave this open for reference or if we ever want to return and get auto power off, but lets not do any more work on it for these first installs.

Closed 2017-07-03.

Thread 107 (2017-06-14):

New Integration Test and Wiring with Reclaimed Pins

cefn, 2017-06-14:
To avoid screen glitch I have wired Reader SPI and Screen SPI separately. This loses some pins.

I have also retired any software-controlled Reset on both boards, and retired SlaveSelect on the screen. This reclaims some pins.

The wiring notes in this issue are intended to supercede https://github.com/cheapjack/MileCastles/issues/86

The screen is wired to rainbow cable - face down with the '20' mark on the right, counting down from right to left - as follows....
* Screen Loom 1 (Far right 6 pins 20-15)
  *  Brown, Red, Black, White, Grey, Purple
* Screen Loom 2 (Far left 6 pins 1-6)
  * Blue, Green, Yellow, Orange, [Red, Brown TWISTED] !! Keeps Red +5v, Brown GND
* Reader Loom (All 8 pins)
  * Black, White, Purple, Blue, Green, Yellow, Orange

# Loom to Cockle wiring details

## Screen Loom 1

BLK -> 0V [Brown] - Backlight Cathode
BLA -> 5V [Red] - Backlight Anode
VOUT -> UNCONNECTED [Black] - Reference voltage
RST -> 5V [White] - Screen Reset
NC -> UNCONNECTED [Grey] -  Not Connected (unused pin)
PSB -> 0V [Purple] - Parallel Serial Bus selector (indicating we are using Serial - SPI)

## Screen Loom 2

**E-> D2/GPIO4 [Blue] - SPI SCK (Serial Clock)**
**R/W -> D1/GPIO10 [Green] - SPI MOSI**
**RS -> 5V [Yellow] - Screen SPI Slave Select**
V0 -> 5V [Orange] - LCD Contrast voltage
VCC -> 5V [Red] - Power supply +5V positive
GND -> GND [Brown] - Power supply common negative

## Reader Loom

SDA -> D4/GPIO2 (Black) - Reader SPI Slave Select
SCK -> D5/GPIO1 (White) - SPI Serial Clock
MOSI -> D7/GPIO13 (Grey) - SPI MOSI
MISO -> D6/GPIO12 (Purple) - SPI MISO
IRQ -> UNCONNECTED (Blue) - Interrupt Request Pin (as yet unused)
GND -> GND (Green) - Power supply common negative
**RST -> 3.3V (Yellow) - Reader Reset**
3.3V -> 3.3V (Orange) - Low Power supply +3.3V positive

Have to go to a meeting right now, but I just tested this wiring sequence from scratch and looks fine for new integration.bin image.

cheapjack, 2017-06-14:
👍 wiring up now

cheapjack, 2017-06-14:
Made wiring changes in bold for ease in your comment

cheapjack, 2017-06-14:
upload firmware in /avatap/firmware with
`esptool.py --port /dev/tty.SLAB_USBtoUART --baud 115200 write_flash --flash_mode dio --flash_size=32m 0 integration-test.bin`

cefn, 2017-06-14:
The draft images are geared up for responsiveness, not avoiding glitchiness. So at the time of writing they DO NOT refresh the screen every time, demonstrating that most of the time the redraw logic does work.

The mystifying logic which maps from rectangles to selective blocks of pixels in the ST7920 (and seems to be broken) is the send address and data bit at the bottom of the redraw() method in https://github.com/ShrimpingIt/micropython-st7920/blob/master/st7920.py

Changing the images to redraw the whole screen may be needed if selective writing is not possible.

cheapjack, 2017-06-23:
@cefn just re-wired and tested the Corbridge outdoor box again and the reed switch triggers power up as normal wired into `D2`. However immediately powers back off as if the cockle is triggering the D2; is this because it's used in the reader as SCK? Have we actually got the power off cycle in the current images for the outdoor boxes.

I guess we have `D3` and `D0` free now, should I use one of these? Ive tried `D3` but has same behaviour. Its not anything else bypassing the reed switch is all fine. Ive some time Monday 26th and Tuesday 27th to try sort this out before install.

cheapjack, 2017-06-27:
Now removed the auto power  off and Pin juggling see issue #104

cheapjack, 2017-07-09:
# Final Loom to Cockle wiring details *(note bold text are changes required from first wiring spec)*

## Screen Loom 1

BLK -> 0V [Brown] - Backlight Cathode
BLA -> 5V [Red] - Backlight Anode
VOUT -> UNCONNECTED [Black] - Reference voltage
RST -> 5V [White] - Screen Reset
NC -> UNCONNECTED [Grey] -  Not Connected (unused pin)
PSB -> 0V [Purple] - Parallel Serial Bus selector (indicating we are using Serial - SPI)

## Screen Loom 2

**E-> D2/GPIO4 [Blue] - SPI SCK (Serial Clock)**
**R/W -> D1/GPIO10 [Green] - SPI MOSI**
**RS -> 5V [Yellow] - Screen SPI Slave Select**
V0 -> 5V [Orange] - LCD Contrast voltage
VCC -> 5V [Red] - Power supply +5V positive
GND -> GND [Brown] - Power supply common negative

## Reader Loom

SDA -> D4/GPIO2 (Black) - Reader SPI Slave Select
SCK -> D5/GPIO1 (White) - SPI Serial Clock
MOSI -> D7/GPIO13 (Grey) - SPI MOSI
MISO -> D6/GPIO12 (Purple) - SPI MISO
IRQ -> UNCONNECTED (Blue) - Interrupt Request Pin (as yet unused)
GND -> GND (Green) - Power supply common negative
**RST -> 3.3V (Yellow) - Reader Reset**
3.3V -> 3.3V (Orange) - Low Power supply +3.3V positive

## Pololu power trip for Outdoor boxes:

![img](https://a.pololu-files.com/picture/0J6761.350.jpg?a49cd139840f29608e58b4b0a77d

10k pull-down resistor between `CTRL` on Pololu and `GND` on Pololu and then the reed switch wired between `5V` & `CTRL` wired in it's normally closed config with the magnet contact keeping it open ie When lid is lifted the switch reverts to it's normally closed position and connects `CTRL` to `5V` so pulses `HIGH` from the `LOW` that the pull-down resistor is keeping low. At least that's how I understand it and it works!

Closed 2017-06-23.

Thread 114 (2017-07-03):

Re-flash the Corbridge game images with optimized ones

cheapjack, 2017-07-03:
Now we've got the new optimised game images for corbridge be good if @cefn could go up and reflash the boxes as its  just so much faster! They have already raised concern about game play  speed but how they are optimised now adresses that completely I think.

We are still waiting on their feedback re the outdoor box which may result in us not proceeding with Housesteads insall

If @cefn you could go up once we've got that feedback that would be really helpful so maybe think when you could do that at some point this month. If we do the Housesteads install after all @gkboulter could come along.

cheapjack, 2017-07-09:
Ive just been going over the final batch of boxes and I think I've mistakenly used an outdoor box with dodgy data cables on the USB for `Corbridge Box IV`.

If we do have to install Housesteads we dont have spares and It means you're going to have to unscrew the 2 leftmost fixings on the box to detach from  the fixings on the sign (too risky to unscrew fixings, we just want to unscrew the extra long screws that attach the box to the steel brackets). Take note of the nut and washer arrangements on the 2 left most bolts, noting their additional length as this must be reproduced when returning the fixed up box.

Take the box somewhere dry and flat and open it up to access the cockle directly which means taking the screen off its standoffs.

Take care when opening the cover; gently lift 1-2cm from base and tilt 20 degrees to left to safely disconnect the black jumper to the right (when looking down at the lid with the base (USB output) of box at the bottom) of the reed switch; be **very** careful when disconnecting and reconnecting, although secure in glue it can still be cracked if pulled carelessly .

Then when black jumper disconnected rotate the lid, keeping the red jumper attached to the other side of the reed switch and lay to the left of the unit.

Then remove the screen from standoffs while still connected and directly access the cockle USB-B to reflash.

Re attach the screen allowing space for it to be pushed back when cover is screwed back in.

Carefully lift the cover back up and to the first position 2cm above the box, **gently** re-attach the black jumper to reed switch and carefully lower cover into position, making sure the red and black jumpers from the reed switch do not snag on other standoffs/RFIDs

If Frances decides she does not want to pursue Housesteads, which seems likely due to staffing, then we can use one of the Housesteads boxes to re-flash and just swap out the corbridge box by taking out the leftmost screws of an outdoor box and threading back into the corbirdge outdoor sign fixings, the extra long nuts with bolt and washer arrangement described above.

cheapjack, 2017-07-09:
I've flashed box `Housesteads IV` with `corbridge/optimised4.bin` if we don't do Housesteads at all we can use that and just swap it out instead of opening up the current `corbidge IV`

The current `corbridge IV` box lost some of the waterproof box's integrity when one of the grey screws snapped on the top right corner, so replacing it with `Housesteads IV` would sort this out also.

Closed 2017-07-19.

Thread 115 (2017-07-07):

Install at final three/four sites

gkboulter, 2017-07-07:
Just putting this in one place for reference, so I can keep track whilst away.

GB to:
- [x] Send install docs to Frances / Alex / Jane refer to issue #93
- [x] Send staff guide docs to Frances / Alex / Jane
- [x] Get confirmation from Frances on Corbridge (not Housesteads) for 18th
- [x] Order 800 or  600 new prints for final sites
- [x] Fold 600/800 maps for final sites
- [x] Finish stickering remaining 800 tags
- [x] Send approved ARBEIA game to @cheapjack
- [x] Wait for approval on (Housesteads not being used) and Segy (due Friday 7th) and check
- [x] Send approved HSTEADS / SEGY to @cheapjack
- [x] Confirm times with Corbridge (instead of Housesteads)  and Senhouse for Tues 18th
- [x] Source cordless drill if @cheapjack not able to borrow from Does

@cefn :
- [x] @cefn to collect boxes and all brackets / fixings from @cheapjack
- [x] @cefn to flash boxes with final games (SENHOUSE / HOUSTEADS / SEGY / ARBEIA)
- [x] Glenn to confirm meet up times for 17th /18th installs with @cefn
- [x] Glenn and @cefn to install remaining sites on 17th / 18th

and @cheapjack:
- [x] @cheapjack to send game text to Jayne at SENHOUSE for approval
- [x] Arrange pickup of boxes etc. with @cefn
- [x] Provide cordless drill for @cefn & @gkboulter to borrow
- [x] Sege battery holder as in #63

cheapjack, 2017-07-09:
Take note of recent comments in issue #114 before re-flashing `corbridge IV`
Drill is from Patrick in DoES so when Ive arranged date to handover boxes to Cefn I will get that drill unless @cefn has his own powerful cordless drill

cheapjack, 2017-07-19:
updated [milecastles webpage](http://milecastles.uk) to reflect latest install/deinstall

Closed 2017-08-10.

Thread 116 (2017-07-11):

Box and venue Reference for Final Installs

cheapjack, 2017-07-11:
## Game-Box Install Overview

Live updated [install dates as github issue milestones](https://github.com/cheapjack/MileCastles/milestones)
[Milecastles Site & Logistics Map](https://drive.google.com/open?id=1v-ztNkkMKAI2DC3aoESozsnM2fI&usp=sharing)
[Detailed Info From Site Visits](https://docs.google.com/spreadsheets/d/1O9EbYnrRbLq14Vwc4btC5YH3rWIDOSFfX5Bne3iuhpo/edit?usp=sharing)

## Arbeia (2 indoor, 1 outdoor)
|Venue|Location|Date|Time|Postcode|Phone|Installed|Image No.
|----|----|----|----|----|----|----|----
|Arbeia Roman Fort and Museum|South Shields|tbc|pending|NE33 2BB|0191 277 1410|NO|

|Number of Boxes|Box Type|USB data|Power|Notes
|----|----|----|----|----
|`I,II`|Indoor|OK|OK|
|`III`|Outdoor|Bad|OK|Will require steel brackets and additional length bolts on top 2 box bolts arranged vertically (supplied). See notes on opening outdoor boxes #114

## Corbridge (3 indoor, 1 outdoor)
|Venue|Location|Date|Time|Postcode|Phone|Installed|Image No.
|----|----|----|----|----|----|----|----
|Corbridge Roman Town|Corbridge|28/6/17|11:30 - 16:30|NE45 5NT|0370 333 1181|YES|YES|1(`corbridge/box*.bin`)

|Number of Boxes|Box Type|USB data|Power|Notes
|----|----|----|----|----
|`I,II,III`|Indoor|OK|OK|
|`IV`|Outdoor|Bad|OK| See notes on opening outdoor boxes #114

## Housesteads (1 indoor, 3 outdoor)
|Venue|Location|Date|Time|Postcode|Phone|Installed|Image No.
|----|----|----|----|----|----|----|----
|Housesteads Roman Fort|Hexham|tbc|tbc|NE47 6NW|01434 344363|NO|NO|

|Number of Boxes|Box Type|USB data|Power|Notes
|----|----|----|----|----
|`I`|Indoor|OK|OK|
|`II`|Outdoor|OK|OK|
|`III,IV`|Outdoor|Bad|OK|See notes on opening outdoor boxes #114

## Segedunum (4 indoor, 1 with battery)
|Venue|Location|Date|Time|Postcode|Phone|Installed|Image No.
|----|----|----|----|----|----|----|----
|Segedunum Roman Fort and Baths|Wallsend|tbc|pending|NE28 6HR|0191 278 4217|NO|NO|

|Number of Boxes|Box Type|USB data|Power|Notes
|----|----|----|----|----
|`I,II,III,IV`|Indoor|OK|OK|`Box IV` needs a battery although its an indoor box. Clear acrylic battery holder with screws supplied

## Senhouse (3 indoor)
|Venue|Location|Date|Time|Postcode|Phone|Installed|Image No.
|----|----|----|----|----|----|----|----
|Senhouse Roman Museum|Maryport|tbc|tbc|CA15|01900 816168|NO|NO|

|Number of Boxes|Box Type|USB data|Power|Notes
|----|----|----|----|----
|`I,II,III`|Indoor|OK|OK|

## Tullie House (4 indoor)
|Venue|Location|Date|Time|Postcode|Phone|Installed|Image No.
|----|----|----|----|----|----|----|----
|Tullie House Museum and Art Gallery|Carlisle|29/6/17|13:00 - 16:00|CA3 8TP|011228 618718|YES|NO|2(`optimised*.bin`)

|Number of Boxes|Box Type|USB data|Power|Notes
|----|----|----|----|----
|`I,II,III,IV`|Indoor|OK|OK|

Closed 2017-07-19.
