cheapjack/MileCastles/boxes/Avatap-box-141W-55H-171.D-3mmDESIGN+offset.pdf

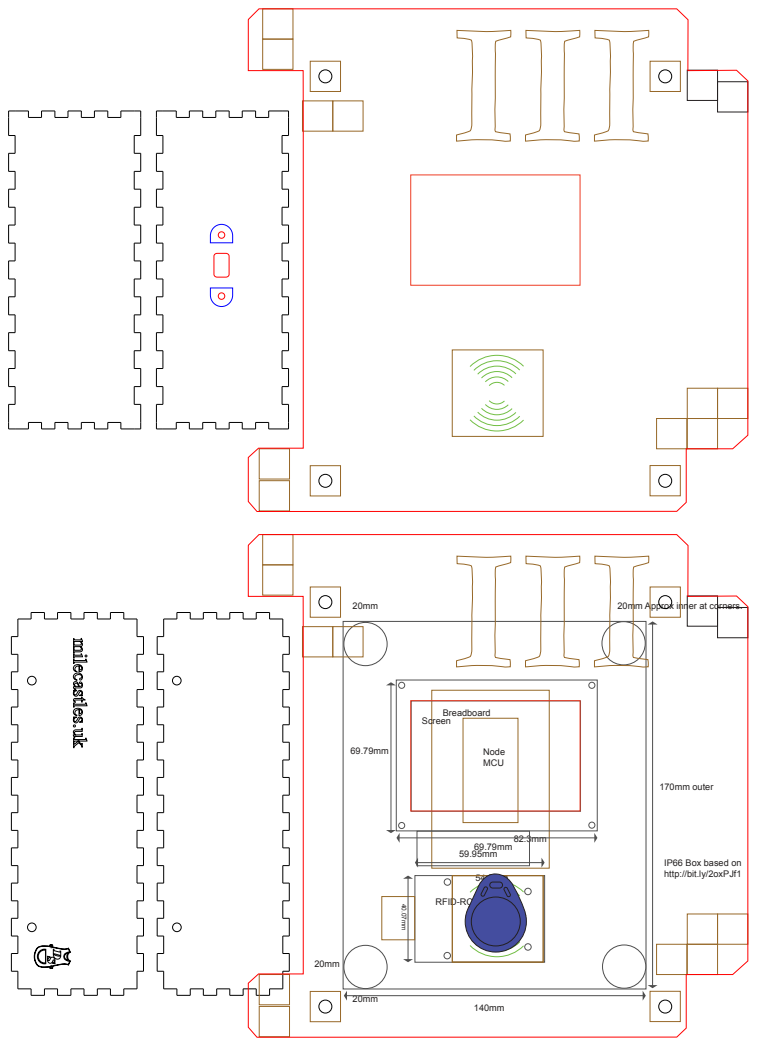
[picture p19: page 1]
170mm outer; 20mm Approx inner at corners.; Breadboard; Node MCU; Screen; RFID-RC522; 6.5mm square collar; 15mm head

IP66 Box based on
http://bit.ly/2oxPJf1
