cheapjack/MileCastles/boxes/Avatap-box-141W-96H-171.D-3mm.pdf

# AVATAP CUT FILES 1

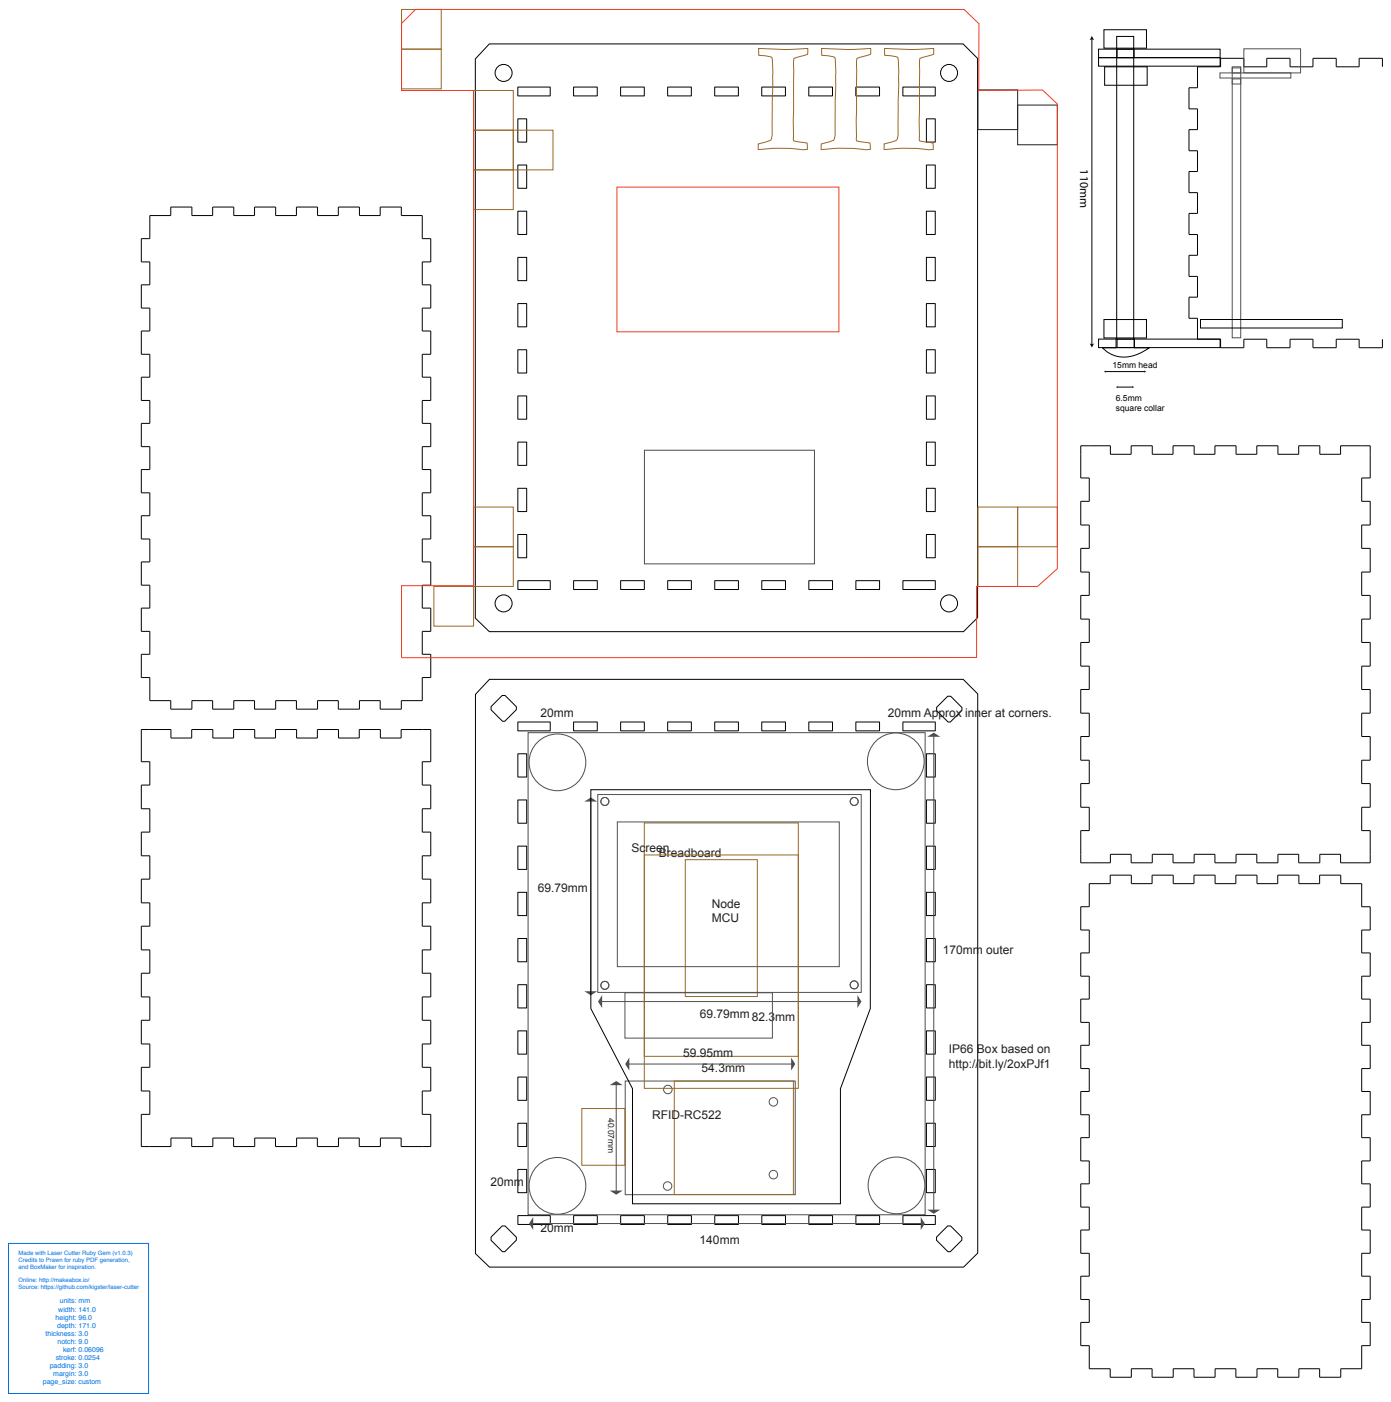
[picture p20: page 1]
units: width: height: depth: thickness: notch: kerf: stroke: padding: margin: page_size:; mm 141.0 96.0 171.0 3.0 9.0 0.06096 0.0254 3.0 3.0 custom; 170mm outer; 20mm Approx inner at corners.; Breadboard; Node MCU; Screen; RFID-RC522; 6.5mm square collar; 15mm head

IP66 Box based on
http://bit.ly/2oxPJf1

Made with Laser Cutter Ruby Gem (v1.0.3)
Credits to Prawn for ruby PDF generation,
and BoxMaker for inspiration.
Online: http://makeabox.io/
Source: https://github.com/kigster/laser-cutter
