cheapjack/MileCastles/boxes/BoxForMap.pdf

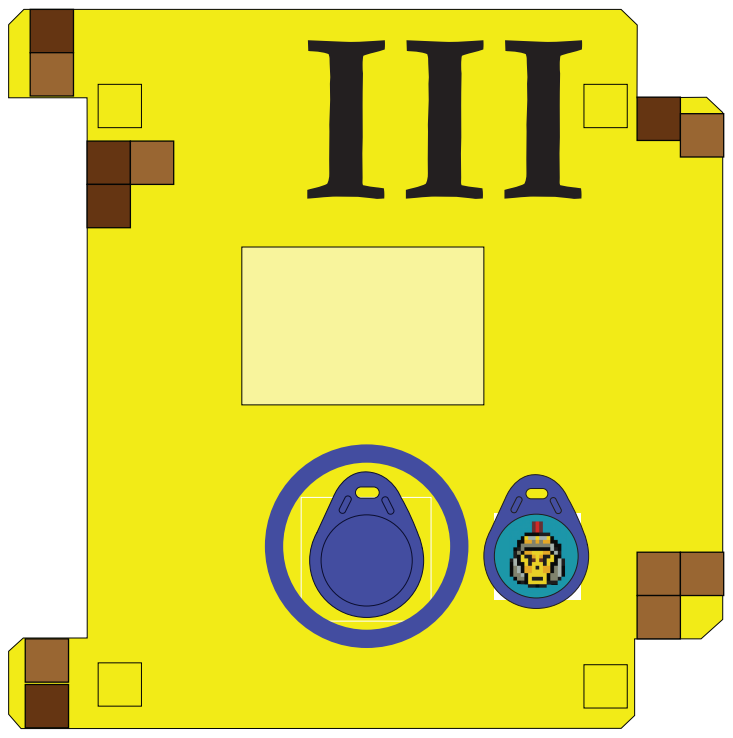
[picture p21: page 1]
III
