cheapjack/MileCastles/boxes/VINDOTEXTUREref.pdf

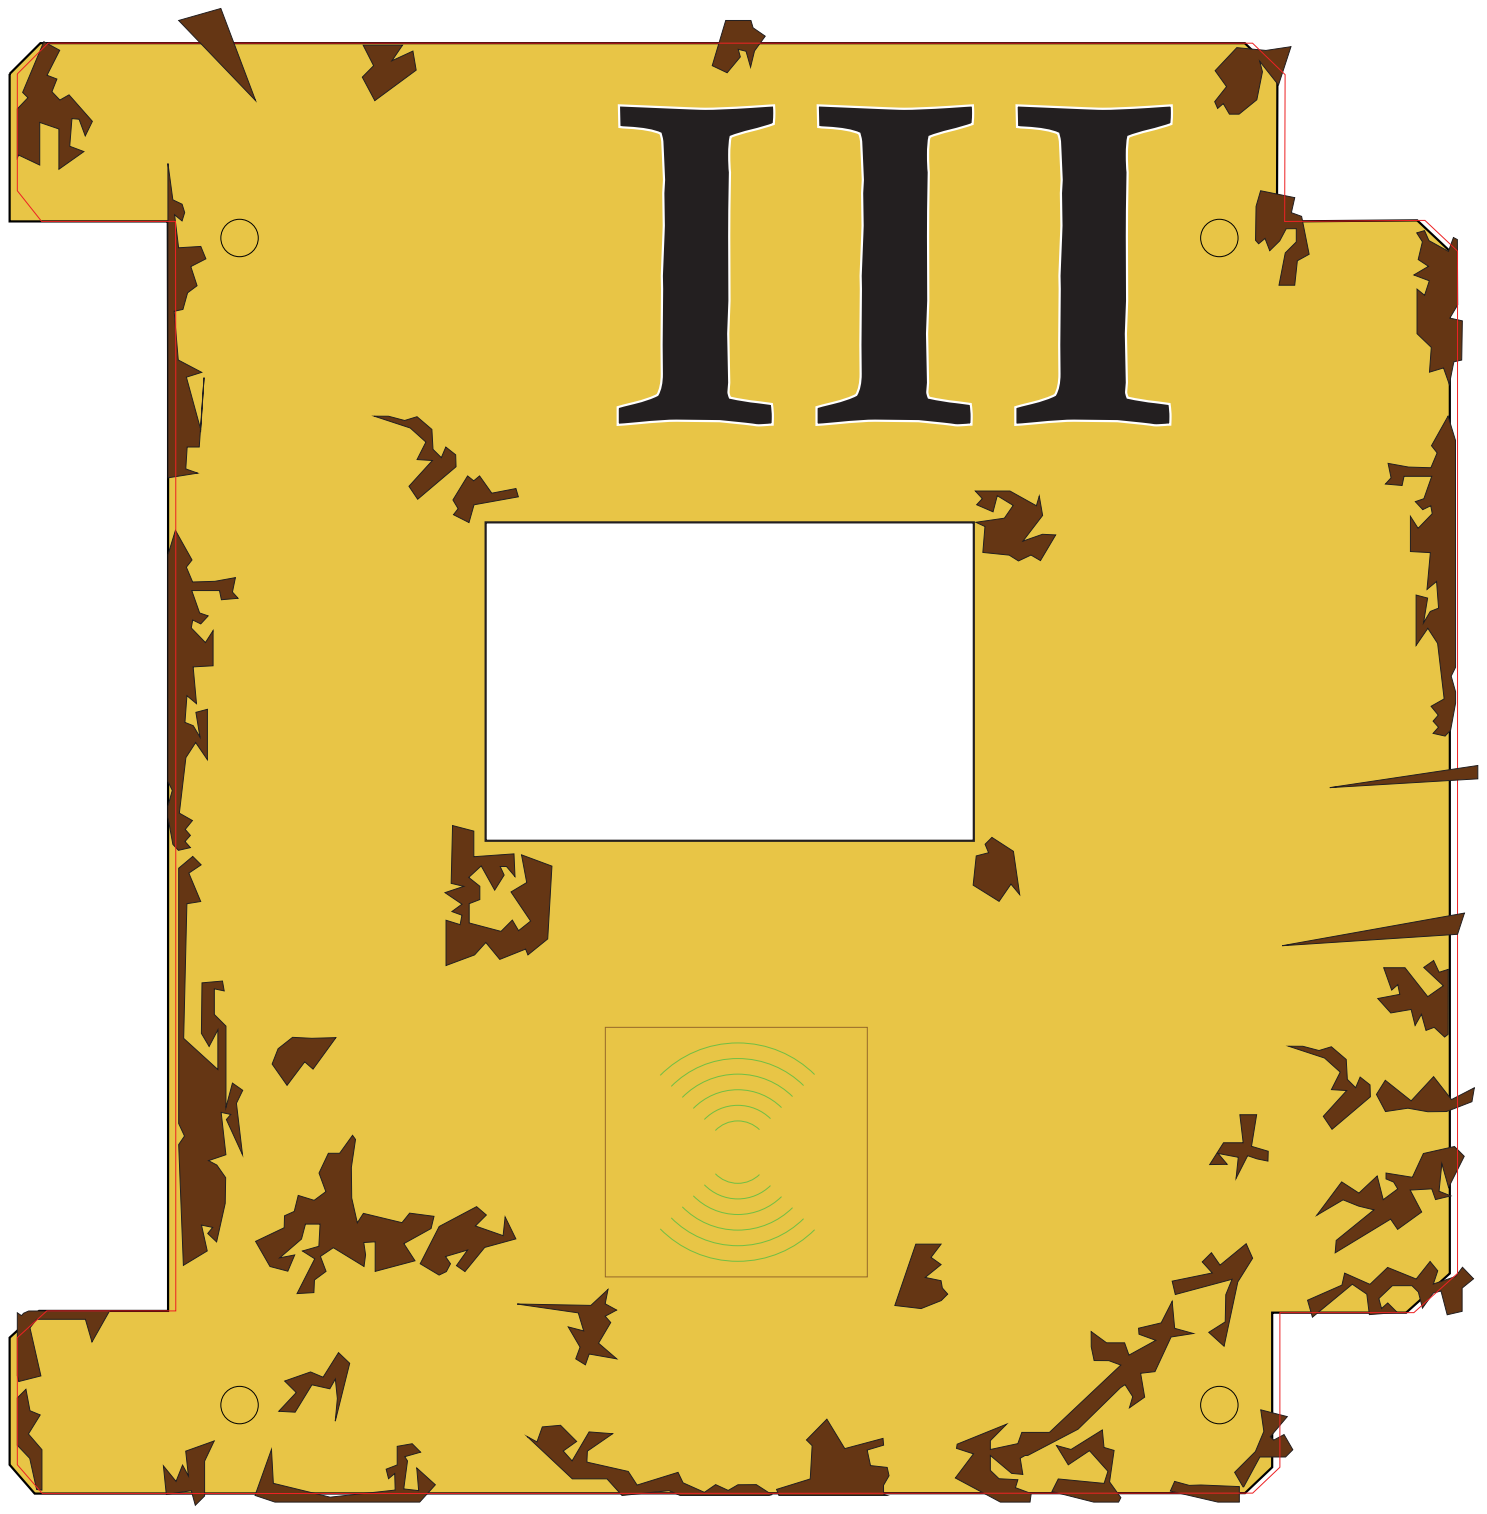
[picture p22: page 1]
