cheapjack/MileCastles/(commit log)

2017-04-03 added prototype box designs for testing
2017-04-17 Added dxf cut files with ai & svg versions
    [AVATOP-INNER-55H-CutsOnSheet.dxf]
2017-04-17 Added a hex nut cap for 3d printing in brown PLA
    [hexnut_tile_cap.stl]
2017-04-25 Added new ref for how to tap, BoxForMap.pdf plus corrected hex nut tile cap
    [hexnut_tile_cap.stl]
2017-04-25 Useful stuff for revised print, revised offset cut & design files, tag and current intstall overview for @cefn
2017-04-25 Added Wiring references & a component list
2017-06-12 Added print proofs from issue #41
